ben5049/GbE-TSN-Switch/Documentation/Images/RGMII MAC-PHY.png

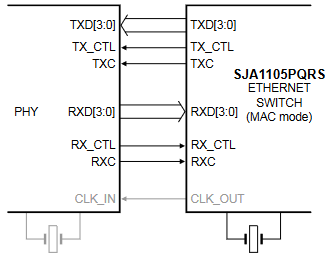
Documentation/Images/RGMII MAC-PHY.png
