ben5049/GbE-TSN-Switch/PCBs/component_library/switch_models/PCM12SMTR.stp

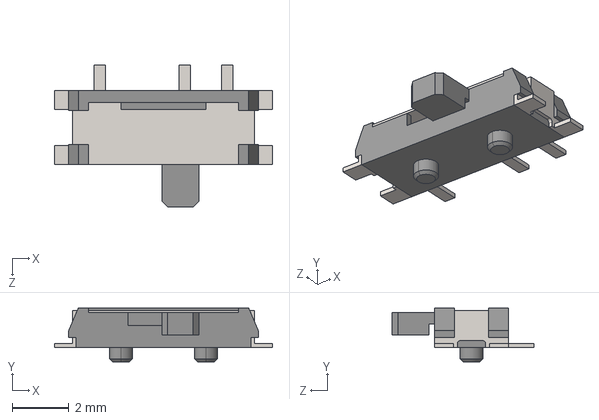
[picture p2: CAD file, 2024-04-11]
PCBs/component_library/switch_models/PCM12SMTR.stp
7.70 x 1.90 x 5.00 mm
