ben5049/GbE-TSN-Switch/PCBs/component_library/switch_models/STM32H573IIK3Q.step

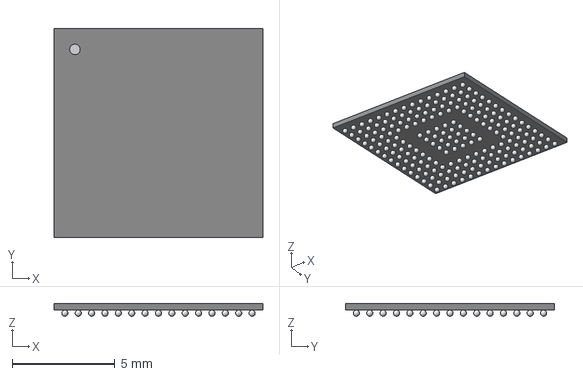
[picture p3: CAD file, 2024-04-11]
PCBs/component_library/switch_models/STM32H573IIK3Q.step
10.2 x 10.2 x 0.612 mm
