ben5049/GbE-TSN-Switch/PCBs/component_library/switch_models/FTSH-107-01-L-DV-K.stp

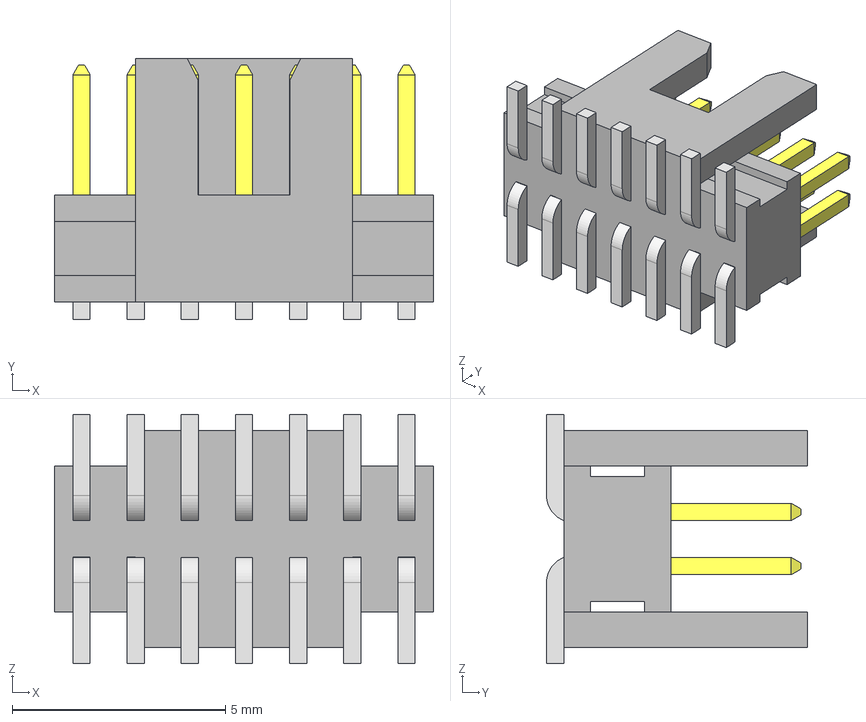
[picture p4: CAD file, 2024-04-11]
PCBs/component_library/switch_models/FTSH-107-01-L-DV-K.stp
8.89 x 6.12 x 5.84 mm
FTSH-107-01-L-DV-K_pins2
FTSH-107-01-L-DV-K_pins1
FTSH-107-01-L-DV-K_body
