ben5049/GbE-TSN-Switch/PCBs/component_library/switch_models/TPD4S012DRYR.stp

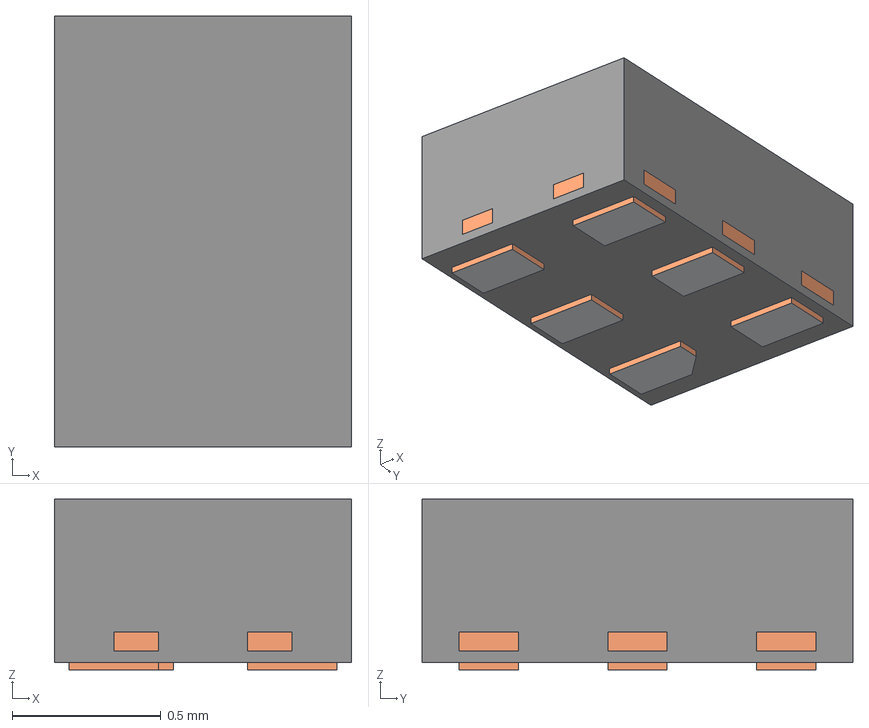
[picture p5: CAD file, 2024-04-11]
PCBs/component_library/switch_models/TPD4S012DRYR.stp
1.00 x 1.45 x 0.575 mm
BODY-SON
FRAME-DRY0006A
PIN1-ID
