ben5049/GbE-TSN-Switch/PCBs/component_library/switch_models/SRF7035A-301Y.stp

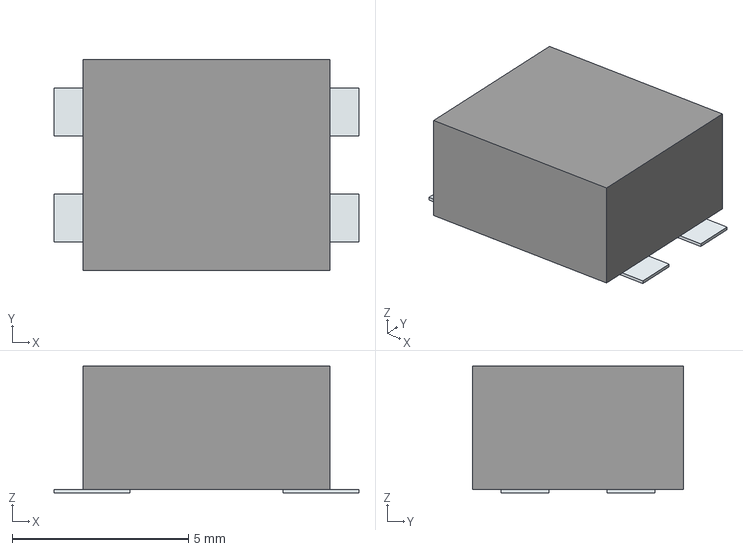
[picture p6: CAD file, 2024-04-09]
PCBs/component_library/switch_models/SRF7035A-301Y.stp
8.66 x 6.00 x 3.60 mm
Pins
