ben5049/GbE-TSN-Switch/PCBs/component_library/switch_models/SRF4532-110Y.stp

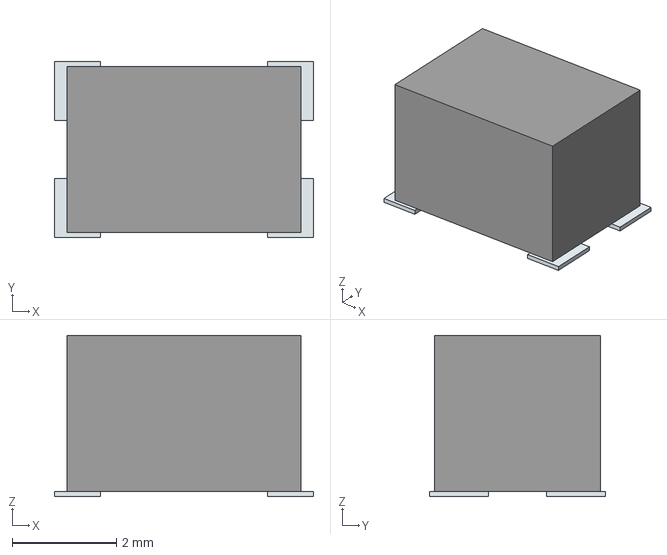
[picture p7: CAD file, 2024-04-09]
PCBs/component_library/switch_models/SRF4532-110Y.stp
4.98 x 3.38 x 3.10 mm
Pins
