ben5049/GbE-TSN-Switch/PCBs/component_library/switch_models/ESD8708MUTAG.stp

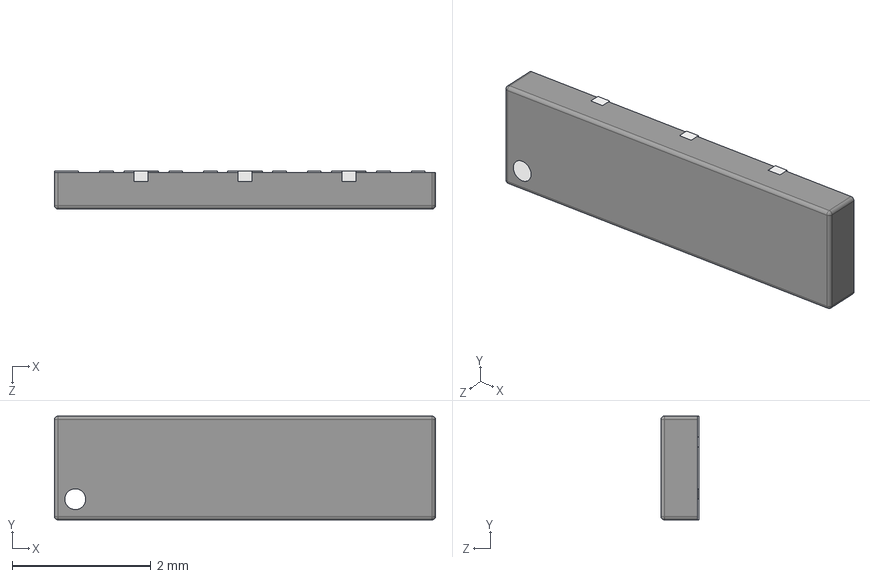
[picture p8: CAD file, 2024-04-07]
PCBs/component_library/switch_models/ESD8708MUTAG.stp
5.50 x 1.50 x 0.55 mm
