ben5049/GbE-TSN-Switch/PCBs/component_library/switch_models/PESD2CANFD24V-TR.stp

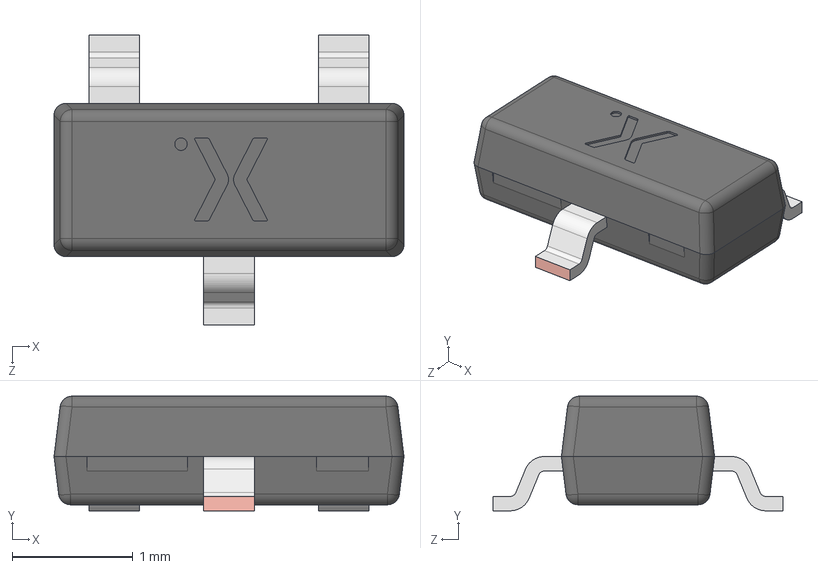
[picture p9: CAD file, 2024-04-06]
PCBs/component_library/switch_models/PESD2CANFD24V-TR.stp
2.90 x 0.95 x 2.40 mm
SOT23 lower body
SOT23 Lead x 3
SOT23 Upper body
