ben5049/GbE-TSN-Switch/PCBs/component_library/switch_models/Diodes_Incorporated_-_DMTH6016LPSQ-13.step

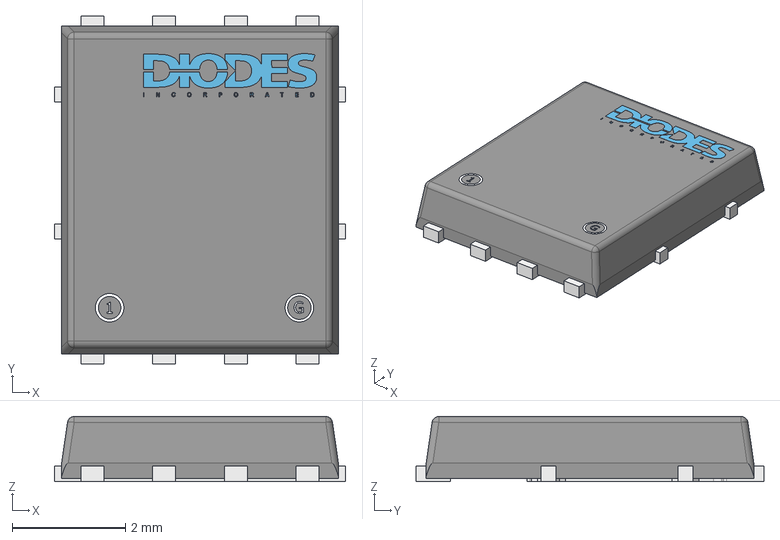
[picture p10: CAD file, 2024-04-05]
PCBs/component_library/switch_models/Diodes_Incorporated_-_DMTH6016LPSQ-13.step
5.15 x 6.15 x 1.15 mm
