ben5049/GbE-TSN-Switch/PCBs/component_library/switch_models/TS20-42-25-WT-160-SMT-TR-MSL.stp

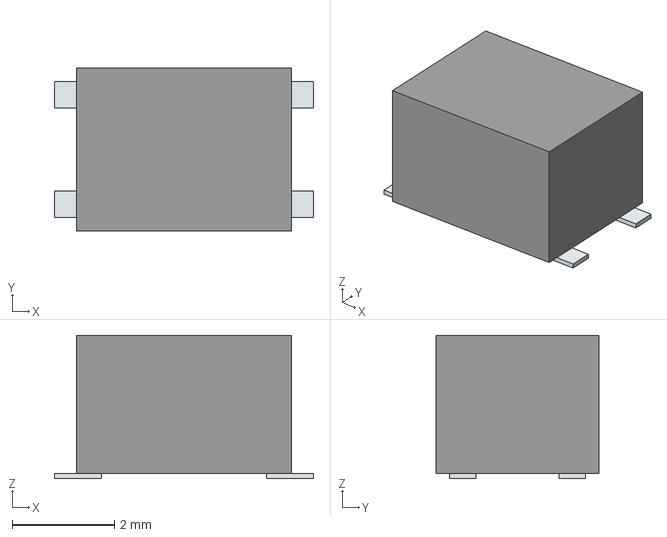
[picture p11: CAD file, 2024-04-05]
PCBs/component_library/switch_models/TS20-42-25-WT-160-SMT-TR-MSL.stp
5.07 x 3.20 x 2.80 mm
Pins
