ben5049/GbE-TSN-Switch/PCBs/component_library/switch_models/PJ-002AH.stp

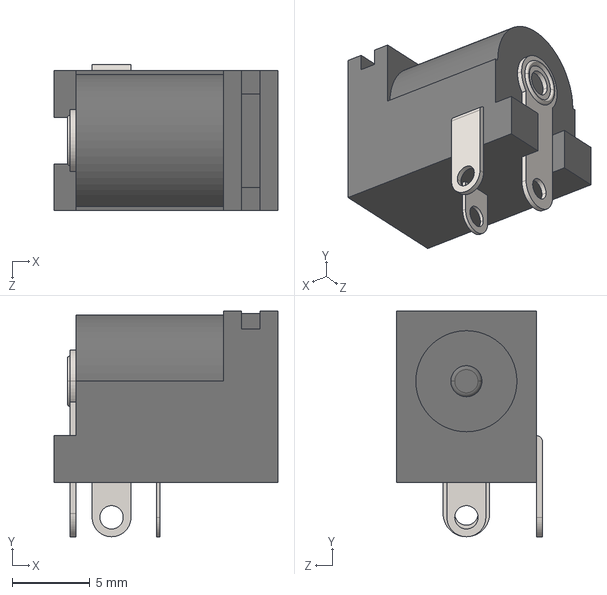
[picture p12: CAD file, 2024-04-05]
PCBs/component_library/switch_models/PJ-002AH.stp
14.4 x 14.5 x 9.40 mm
