ben5049/GbE-TSN-Switch/PCBs/component_library/switch_models/MPQ5850GJ-AEC1-Z.stp

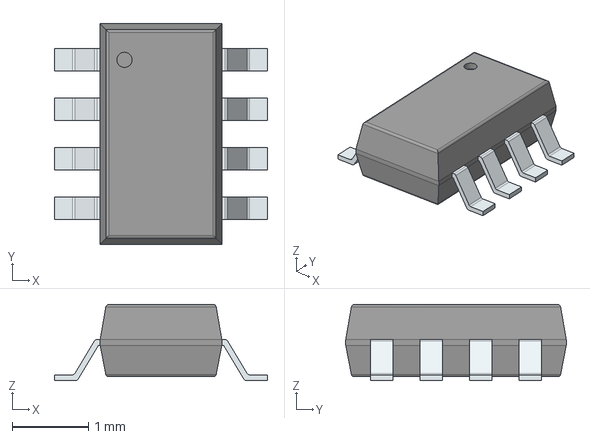
[picture p13: CAD file, 2024-04-05]
PCBs/component_library/switch_models/MPQ5850GJ-AEC1-Z.stp
2.80 x 2.90 x 1.00 mm
PinsArrayLR
