ben5049/GbE-TSN-Switch/PCBs/component_library/switch_models/LT8692s.step

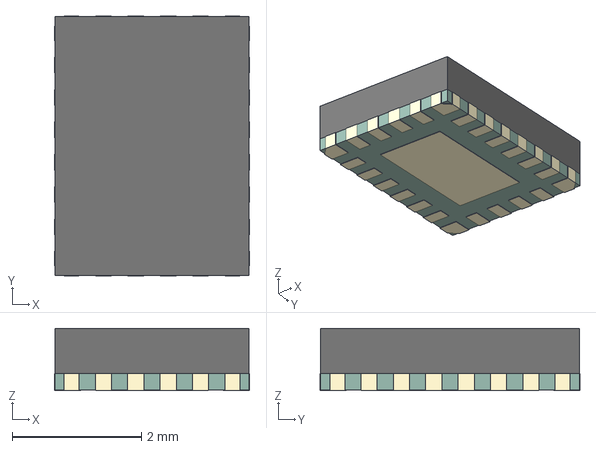
[picture p14: CAD file, 2024-04-05]
PCBs/component_library/switch_models/LT8692s.step
3.02 x 4.02 x 0.96 mm
