ben5049/GbE-TSN-Switch/PCBs/component_library/switch_models/AXGD10402KR.stp

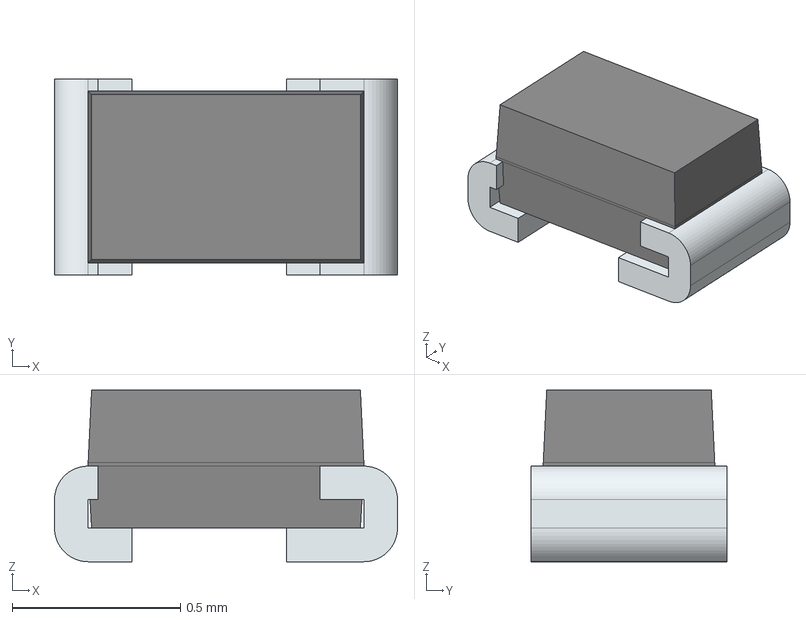
[picture p15: CAD file, 2024-04-05]
PCBs/component_library/switch_models/AXGD10402KR.stp
1.02 x 0.584 x 0.51 mm
FilletPin1
FilletPin2
