ben5049/GbE-TSN-Switch/PCBs/component_library/switch_models/TVS2701DRBR.stp

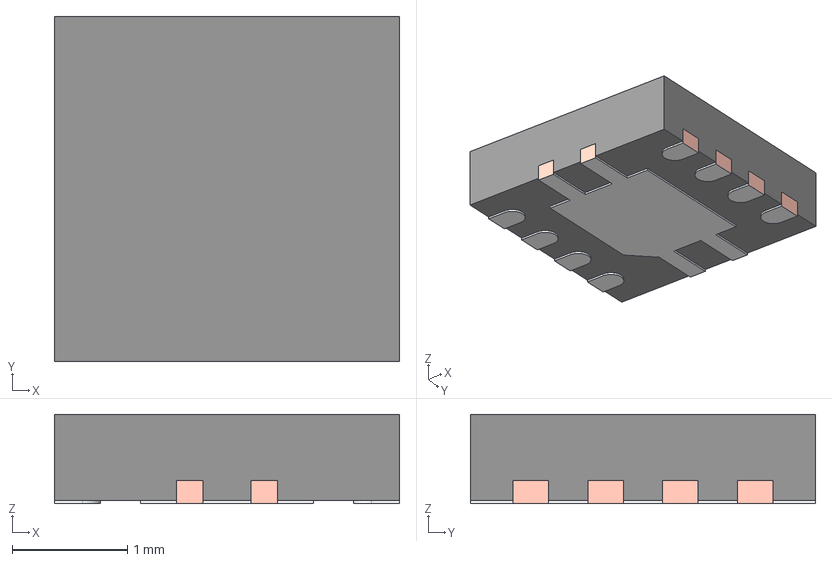
[picture p17: CAD file, 2024-04-05]
PCBs/component_library/switch_models/TVS2701DRBR.stp
3.00 x 3.00 x 0.775 mm
BODY-SON
FRAME-DRB0008A
