ben5049/GbE-TSN-Switch/PCBs/component_library/switch_models/TMJG46945AENL_Web.STEP

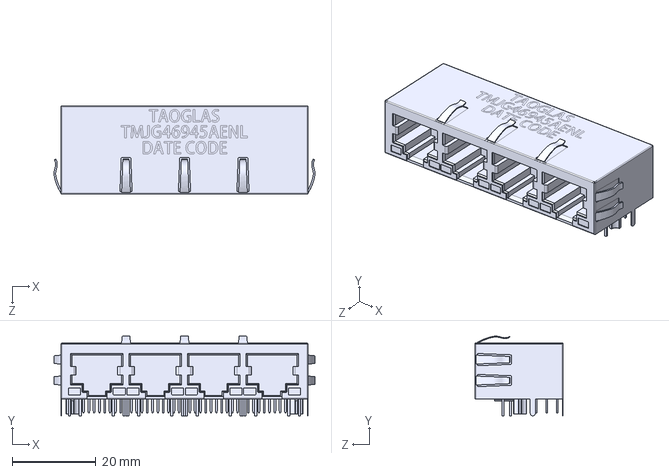
[picture p18: CAD file, 2024-04-05]
PCBs/component_library/switch_models/TMJG46945AENL_Web.STEP
62.4 x 19.0 x 21.1 mm
