ben5049/GbE-TSN-Switch/PCBs/component_library/switch_models/TJA1055T_3_2Z.stp

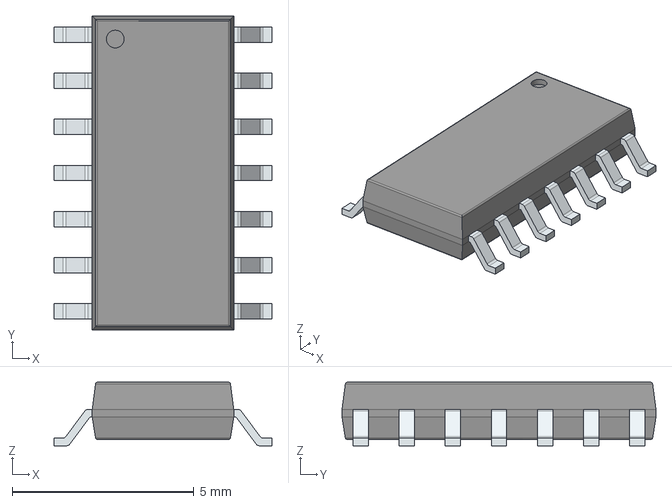
[picture p19: CAD file, 2024-04-05]
PCBs/component_library/switch_models/TJA1055T_3_2Z.stp
6.00 x 8.65 x 1.75 mm
PinsArrayLR
