ben5049/GbE-TSN-Switch/(list of files, cad)

Other CAD files:
PCBs/component_library/switch_models/76825-0004.stp
PCBs/component_library/switch_models/DP83867CSRGZR.stp
PCBs/component_library/switch_models/LMR34206SC5QRNXRQ1.step
PCBs/component_library/switch_models/M24256X-FCU6T_VF.stp
PCBs/component_library/switch_models/STM32H573IIK3Q.stp
PCBs/component_library/switch_models/TPS16416DRCR.stp
