ben5049/GbE-TSN-Switch/PCBs/switch_main_v1/switch_main_v1.kicad_pcb

## KiCad design PCBs/switch_main_v1/switch_main_v1.kicad_pcb (2024-04-11)

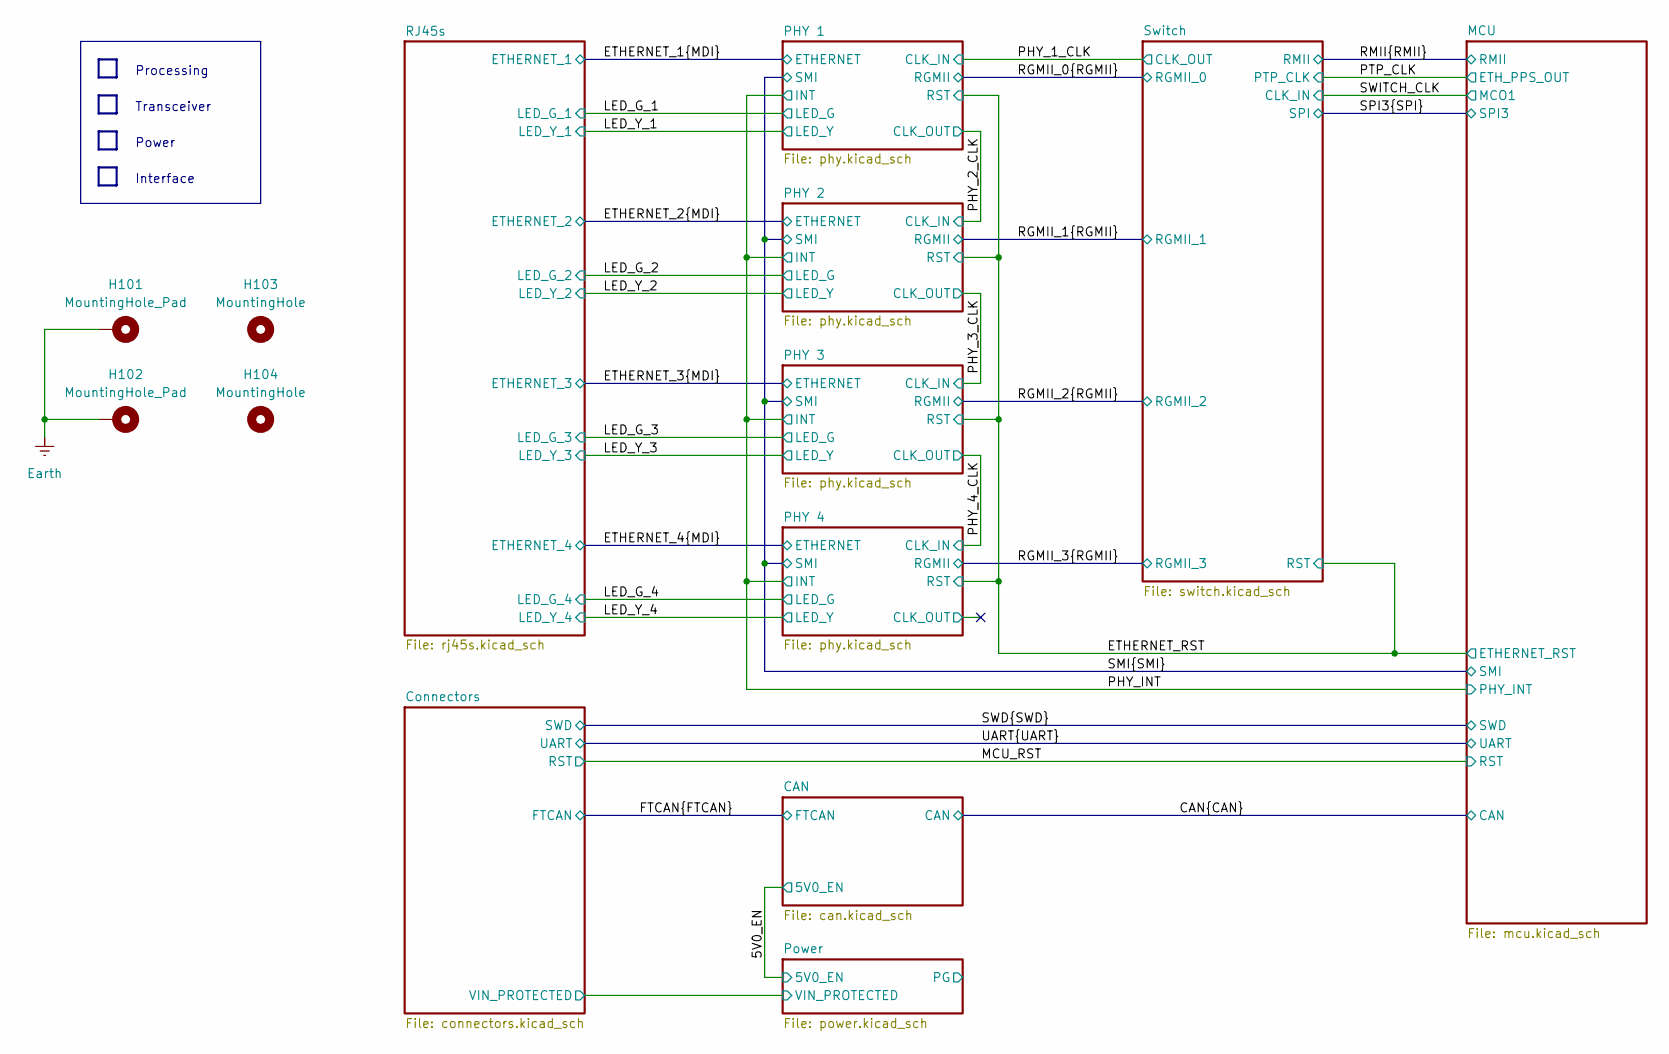
[picture p20: schematic switch_main_v1.kicad_sch, GbE TSN Switch Block Diagram]

Parts:
H101, H102: MountingHole_Pad; MountingHole_3.2mm_M3_DIN965_Pad_TopBottom
H103, H104: MountingHole; MountingHole_3.2mm_M3_DIN965

Connections:
Earth: H101.1, H102.1; also elsewhere on the board

Notes on the sheet:
Processing
Power
Interface
Transceiver

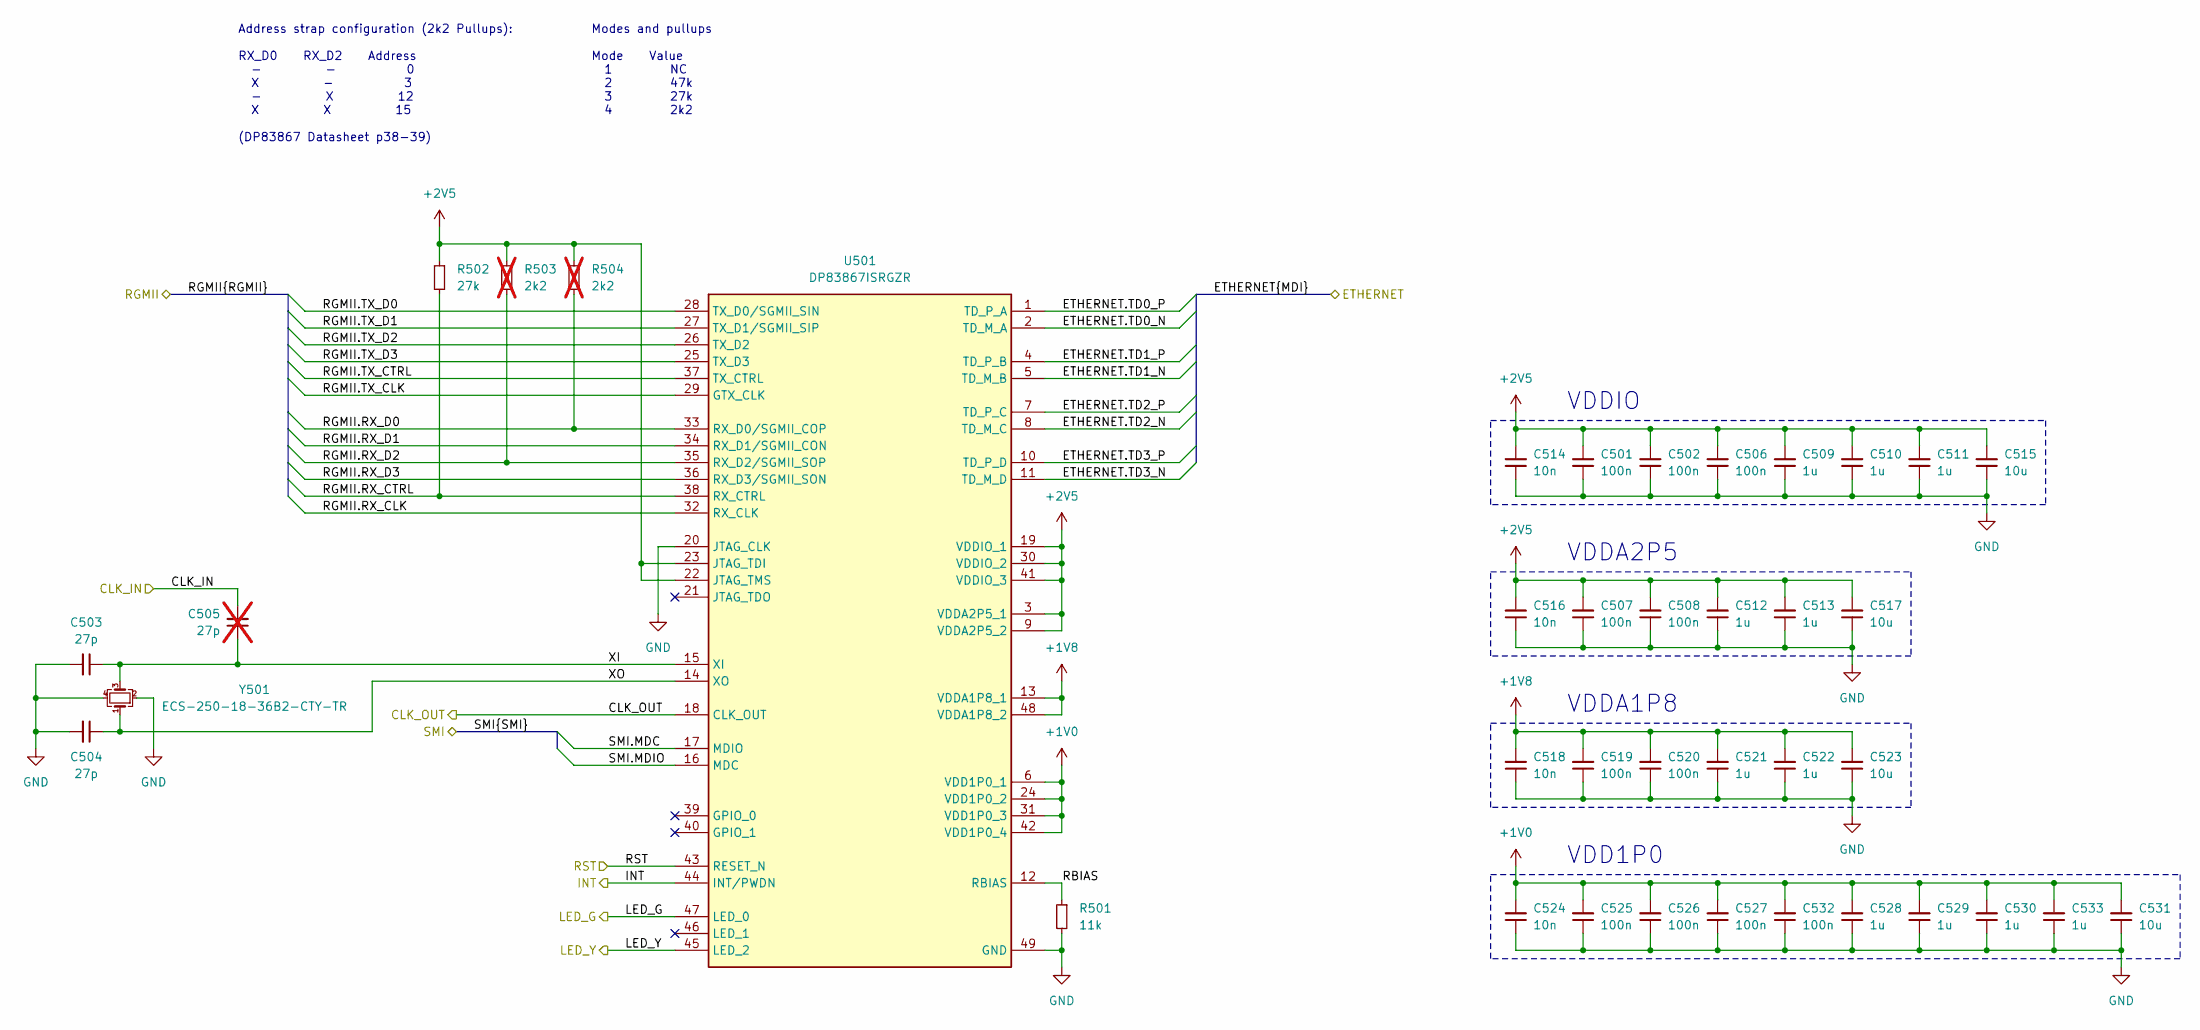
[picture p21: schematic phy.kicad_sch]

Parts:
C501, C502, C506, C507, C508, C519, C520, C525, C526, C527, C532: 100n; C_0402_1005Metric
C503, C504: 27p; C_0402_1005Metric
C505: 27p; C_0402_1005Metric; not fitted
C509, C510, C511, C512, C513, C521, C522, C528, C529, C530, C533: 1u; C_0402_1005Metric
C514, C516, C518, C524: 10n; C_0402_1005Metric
C515, C517, C523, C531: 10u; C_0402_1005Metric
R501: 11k; R_0402_1005Metric
R502: 27k; R_0402_1005Metric
R503, R504: 2k2; R_0402_1005Metric; not fitted
U501: DP83867ISRGZR; QFN50P700X700X100-49N-D; Mouser Part Number 595-DP83867CSRGZR
Y501: ECS-250-18-36B2-CTY-TR; Crystal_SMD_2520-4Pin_2.5x2.0mm

Connections:
+1V0: C524.2, C525.2, C526.2, C527.2, C528.2, C529.2, C530.2, C531.2, C532.2, C533.2, U501.6 (VDD1P0_1), U501.24 (VDD1P0_2), U501.31 (VDD1P0_3), U501.42 (VDD1P0_4); also elsewhere on the board
+1V8: C518.2, C519.2, C520.2, C521.2, C522.2, C523.2, U501.13 (VDDA1P8_1), U501.48 (VDDA1P8_2); also elsewhere on the board
+2V5: C501.2, C502.2, C506.2, C507.2, C508.2, C509.2, C510.2, C511.2, C512.2, C513.2, C514.2, C515.2, C516.2, C517.2, R502.1, R503.1, R504.1, U501.3 (VDDA2P5_1), U501.9 (VDDA2P5_2), U501.19 (VDDIO_1), U501.22 (JTAG_TMS), U501.23 (JTAG_TDI), U501.30 (VDDIO_2), U501.41 (VDDIO_3); also elsewhere on the board
/ETHERNET_1.TD0_N: U501.2 (TD_M_A); also elsewhere on the board
/ETHERNET_1.TD0_P: U501.1 (TD_P_A); also elsewhere on the board
/ETHERNET_1.TD1_N: U501.5 (TD_M_B); also elsewhere on the board
/ETHERNET_1.TD1_P: U501.4 (TD_P_B); also elsewhere on the board
/ETHERNET_1.TD2_N: U501.8 (TD_M_C); also elsewhere on the board
/ETHERNET_1.TD2_P: U501.7 (TD_P_C); also elsewhere on the board
/ETHERNET_1.TD3_N: U501.11 (TD_M_D); also elsewhere on the board
/ETHERNET_1.TD3_P: U501.10 (TD_P_D); also elsewhere on the board
/ETHERNET_RST: U501.43 (RESET_N); also elsewhere on the board
/LED_G_1: U501.47 (LED_0); also elsewhere on the board
/LED_Y_1: U501.45 (LED_2); also elsewhere on the board
/PHY 1/RBIAS: R501.1, U501.12 (RBIAS)
/PHY 1/XI: C503.1, C505.1, U501.15 (XI), Y501.3
/PHY 1/XO: C504.1, U501.14 (XO), Y501.1
/PHY_1_CLK: C505.2; also elsewhere on the board
/PHY_2_CLK: U501.18 (CLK_OUT); also elsewhere on the board
/PHY_INT: U501.44 (INT/PWDN); also elsewhere on the board
/RGMII_0.RX_CLK: U501.32 (RX_CLK); also elsewhere on the board
/RGMII_0.RX_CTRL: R502.2, U501.38 (RX_CTRL); also elsewhere on the board
/RGMII_0.RX_D0: R504.2, U501.33 (RX_D0/SGMII_COP); also elsewhere on the board
/RGMII_0.RX_D1: U501.34 (RX_D1/SGMII_CON); also elsewhere on the board
/RGMII_0.RX_D2: R503.2, U501.35 (RX_D2/SGMII_SOP); also elsewhere on the board
/RGMII_0.RX_D3: U501.36 (RX_D3/SGMII_SON); also elsewhere on the board
/RGMII_0.TX_CLK: U501.29 (GTX_CLK); also elsewhere on the board
/RGMII_0.TX_CTRL: U501.37 (TX_CTRL); also elsewhere on the board
/RGMII_0.TX_D0: U501.28 (TX_D0/SGMII_SIN); also elsewhere on the board
/RGMII_0.TX_D1: U501.27 (TX_D1/SGMII_SIP); also elsewhere on the board
/RGMII_0.TX_D2: U501.26 (TX_D2); also elsewhere on the board
/RGMII_0.TX_D3: U501.25 (TX_D3); also elsewhere on the board
/SMI.MDC: U501.17 (MDIO); also elsewhere on the board
/SMI.MDIO: U501.16 (MDC); also elsewhere on the board
GND: C501.1, C502.1, C503.2, C504.2, C506.1, C507.1, C508.1, C509.1, C510.1, C511.1, C512.1, C513.1, C514.1, C515.1, C516.1, C517.1, C518.1, C519.1, C520.1, C521.1, C522.1, C523.1, C524.1, C525.1, C526.1, C527.1, C528.1, C529.1, C530.1, C531.1, C532.1, C533.1, R501.2, U501.20 (JTAG_CLK), U501.49 (GND), Y501.2, Y501.4; also elsewhere on the board

Parts of its further copies:
C601, C602, C606, C607, C608, C619, C620, C625, C626, C627, C632, C701, C702, C706, C707, C708, C719, C720, C725, C726, C727, C732, C801, C802, C806, C807, C808, C819, C820, C825, C826, C827, C832: 100n; C_0402_1005Metric
C603, C604, C703, C704, C803, C804: 27p; C_0402_1005Metric
C605, C705, C805: 27p; C_0402_1005Metric; not fitted
C609, C610, C611, C612, C613, C621, C622, C628, C629, C630, C633, C709, C710, C711, C712, C713, C721, C722, C728, C729, C730, C733, C809, C810, C811, C812, C813, C821, C822, C828, C829, C830, C833: 1u; C_0402_1005Metric
C614, C616, C618, C624, C714, C716, C718, C724, C814, C816, C818, C824: 10n; C_0402_1005Metric
C615, C617, C623, C631, C715, C717, C723, C731, C815, C817, C823, C831: 10u; C_0402_1005Metric
R601, R701, R801: 11k; R_0402_1005Metric
R602, R702, R802: 27k; R_0402_1005Metric
R603, R604, R703, R704, R803, R804: 2k2; R_0402_1005Metric; not fitted
U601, U701, U801: DP83867ISRGZR; QFN50P700X700X100-49N-D; Mouser Part Number 595-DP83867CSRGZR
Y601, Y701, Y801: ECS-250-18-36B2-CTY-TR; Crystal_SMD_2520-4Pin_2.5x2.0mm

Connections of its further copies:
+1V0: C624.2, C625.2, C626.2, C627.2, C628.2, C629.2, C630.2, C631.2, C632.2, C633.2, C724.2, C725.2, C726.2, C727.2, C728.2, C729.2, C730.2, C731.2, C732.2, C733.2, C824.2, C825.2, C826.2, C827.2, C828.2, C829.2, C830.2, C831.2, C832.2, C833.2, U601.6 (VDD1P0_1), U601.24 (VDD1P0_2), U601.31 (VDD1P0_3), U601.42 (VDD1P0_4), U701.6 (VDD1P0_1), U701.24 (VDD1P0_2), U701.31 (VDD1P0_3), U701.42 (VDD1P0_4), U801.6 (VDD1P0_1), U801.24 (VDD1P0_2), U801.31 (VDD1P0_3), U801.42 (VDD1P0_4); also elsewhere on the board
+1V8: C618.2, C619.2, C620.2, C621.2, C622.2, C623.2, C718.2, C719.2, C720.2, C721.2, C722.2, C723.2, C818.2, C819.2, C820.2, C821.2, C822.2, C823.2, U601.13 (VDDA1P8_1), U601.48 (VDDA1P8_2), U701.13 (VDDA1P8_1), U701.48 (VDDA1P8_2), U801.13 (VDDA1P8_1), U801.48 (VDDA1P8_2); also elsewhere on the board
+2V5: C601.2, C602.2, C606.2, C607.2, C608.2, C609.2, C610.2, C611.2, C612.2, C613.2, C614.2, C615.2, C616.2, C617.2, C701.2, C702.2, C706.2, C707.2, C708.2, C709.2, C710.2, C711.2, C712.2, C713.2, C714.2, C715.2, C716.2, C717.2, C801.2, C802.2, C806.2, C807.2, C808.2, C809.2, C810.2, C811.2, C812.2, C813.2, C814.2, C815.2, C816.2, C817.2, R602.1, R603.1, R604.1, R702.1, R703.1, R704.1, R802.1, R803.1, R804.1, U601.3 (VDDA2P5_1), U601.9 (VDDA2P5_2), U601.19 (VDDIO_1), U601.22 (JTAG_TMS), U601.23 (JTAG_TDI), U601.30 (VDDIO_2), U601.41 (VDDIO_3), U701.3 (VDDA2P5_1), U701.9 (VDDA2P5_2), U701.19 (VDDIO_1), U701.22 (JTAG_TMS), U701.23 (JTAG_TDI), U701.30 (VDDIO_2), U701.41 (VDDIO_3), U801.3 (VDDA2P5_1), U801.9 (VDDA2P5_2), U801.19 (VDDIO_1), U801.22 (JTAG_TMS), U801.23 (JTAG_TDI), U801.30 (VDDIO_2), U801.41 (VDDIO_3); also elsewhere on the board
/ETHERNET_2.TD0_N: U601.2 (TD_M_A); also elsewhere on the board
/ETHERNET_2.TD0_P: U601.1 (TD_P_A); also elsewhere on the board
/ETHERNET_2.TD1_N: U601.5 (TD_M_B); also elsewhere on the board
/ETHERNET_2.TD1_P: U601.4 (TD_P_B); also elsewhere on the board
/ETHERNET_2.TD2_N: U601.8 (TD_M_C); also elsewhere on the board
/ETHERNET_2.TD2_P: U601.7 (TD_P_C); also elsewhere on the board
/ETHERNET_2.TD3_N: U601.11 (TD_M_D); also elsewhere on the board
/ETHERNET_2.TD3_P: U601.10 (TD_P_D); also elsewhere on the board
/ETHERNET_3.TD0_N: U701.2 (TD_M_A); also elsewhere on the board
/ETHERNET_3.TD0_P: U701.1 (TD_P_A); also elsewhere on the board
/ETHERNET_3.TD1_N: U701.5 (TD_M_B); also elsewhere on the board
/ETHERNET_3.TD1_P: U701.4 (TD_P_B); also elsewhere on the board
/ETHERNET_3.TD2_N: U701.8 (TD_M_C); also elsewhere on the board
/ETHERNET_3.TD2_P: U701.7 (TD_P_C); also elsewhere on the board
/ETHERNET_3.TD3_N: U701.11 (TD_M_D); also elsewhere on the board
/ETHERNET_3.TD3_P: U701.10 (TD_P_D); also elsewhere on the board
/ETHERNET_4.TD0_N: U801.2 (TD_M_A); also elsewhere on the board
/ETHERNET_4.TD0_P: U801.1 (TD_P_A); also elsewhere on the board
/ETHERNET_4.TD1_N: U801.5 (TD_M_B); also elsewhere on the board
/ETHERNET_4.TD1_P: U801.4 (TD_P_B); also elsewhere on the board
/ETHERNET_4.TD2_N: U801.8 (TD_M_C); also elsewhere on the board
/ETHERNET_4.TD2_P: U801.7 (TD_P_C); also elsewhere on the board
/ETHERNET_4.TD3_N: U801.11 (TD_M_D); also elsewhere on the board
/ETHERNET_4.TD3_P: U801.10 (TD_P_D); also elsewhere on the board
/ETHERNET_RST: U601.43 (RESET_N), U701.43 (RESET_N), U801.43 (RESET_N); also elsewhere on the board
/LED_G_2: U601.47 (LED_0); also elsewhere on the board
/LED_G_3: U701.47 (LED_0); also elsewhere on the board
/LED_G_4: U801.47 (LED_0); also elsewhere on the board
/LED_Y_2: U601.45 (LED_2); also elsewhere on the board
/LED_Y_3: U701.45 (LED_2); also elsewhere on the board
/LED_Y_4: U801.45 (LED_2); also elsewhere on the board
/PHY 2/RBIAS: R601.1, U601.12 (RBIAS)
/PHY 2/XI: C603.1, C605.1, U601.15 (XI), Y601.3
/PHY 2/XO: C604.1, U601.14 (XO), Y601.1
/PHY 3/RBIAS: R701.1, U701.12 (RBIAS)
/PHY 3/XI: C703.1, C705.1, U701.15 (XI), Y701.3
/PHY 3/XO: C704.1, U701.14 (XO), Y701.1
/PHY 4/CLK_OUT: U801.18 (CLK_OUT)
/PHY 4/RBIAS: R801.1, U801.12 (RBIAS)
/PHY 4/XI: C803.1, C805.1, U801.15 (XI), Y801.3
/PHY 4/XO: C804.1, U801.14 (XO), Y801.1
/PHY_2_CLK: C605.2; also elsewhere on the board
/PHY_3_CLK: C705.2, U601.18 (CLK_OUT)
/PHY_4_CLK: C805.2, U701.18 (CLK_OUT)
/PHY_INT: U601.44 (INT/PWDN), U701.44 (INT/PWDN), U801.44 (INT/PWDN); also elsewhere on the board
/RGMII_1.RX_CLK: U601.32 (RX_CLK); also elsewhere on the board
/RGMII_1.RX_CTRL: R602.2, U601.38 (RX_CTRL); also elsewhere on the board
/RGMII_1.RX_D0: R604.2, U601.33 (RX_D0/SGMII_COP); also elsewhere on the board
/RGMII_1.RX_D1: U601.34 (RX_D1/SGMII_CON); also elsewhere on the board
/RGMII_1.RX_D2: R603.2, U601.35 (RX_D2/SGMII_SOP); also elsewhere on the board
/RGMII_1.RX_D3: U601.36 (RX_D3/SGMII_SON); also elsewhere on the board
/RGMII_1.TX_CLK: U601.29 (GTX_CLK); also elsewhere on the board
/RGMII_1.TX_CTRL: U601.37 (TX_CTRL); also elsewhere on the board
/RGMII_1.TX_D0: U601.28 (TX_D0/SGMII_SIN); also elsewhere on the board
/RGMII_1.TX_D1: U601.27 (TX_D1/SGMII_SIP); also elsewhere on the board
/RGMII_1.TX_D2: U601.26 (TX_D2); also elsewhere on the board
/RGMII_1.TX_D3: U601.25 (TX_D3); also elsewhere on the board
/RGMII_2.RX_CLK: U701.32 (RX_CLK); also elsewhere on the board
/RGMII_2.RX_CTRL: R702.2, U701.38 (RX_CTRL); also elsewhere on the board
/RGMII_2.RX_D0: R704.2, U701.33 (RX_D0/SGMII_COP); also elsewhere on the board
/RGMII_2.RX_D1: U701.34 (RX_D1/SGMII_CON); also elsewhere on the board
/RGMII_2.RX_D2: R703.2, U701.35 (RX_D2/SGMII_SOP); also elsewhere on the board
/RGMII_2.RX_D3: U701.36 (RX_D3/SGMII_SON); also elsewhere on the board
/RGMII_2.TX_CLK: U701.29 (GTX_CLK); also elsewhere on the board
/RGMII_2.TX_CTRL: U701.37 (TX_CTRL); also elsewhere on the board
/RGMII_2.TX_D0: U701.28 (TX_D0/SGMII_SIN); also elsewhere on the board
/RGMII_2.TX_D1: U701.27 (TX_D1/SGMII_SIP); also elsewhere on the board
/RGMII_2.TX_D2: U701.26 (TX_D2); also elsewhere on the board
/RGMII_2.TX_D3: U701.25 (TX_D3); also elsewhere on the board
/RGMII_3.RX_CLK: U801.32 (RX_CLK); also elsewhere on the board
/RGMII_3.RX_CTRL: R802.2, U801.38 (RX_CTRL); also elsewhere on the board
/RGMII_3.RX_D0: R804.2, U801.33 (RX_D0/SGMII_COP); also elsewhere on the board
/RGMII_3.RX_D1: U801.34 (RX_D1/SGMII_CON); also elsewhere on the board
/RGMII_3.RX_D2: R803.2, U801.35 (RX_D2/SGMII_SOP); also elsewhere on the board
/RGMII_3.RX_D3: U801.36 (RX_D3/SGMII_SON); also elsewhere on the board
/RGMII_3.TX_CLK: U801.29 (GTX_CLK); also elsewhere on the board
/RGMII_3.TX_CTRL: U801.37 (TX_CTRL); also elsewhere on the board
/RGMII_3.TX_D0: U801.28 (TX_D0/SGMII_SIN); also elsewhere on the board
/RGMII_3.TX_D1: U801.27 (TX_D1/SGMII_SIP); also elsewhere on the board
/RGMII_3.TX_D2: U801.26 (TX_D2); also elsewhere on the board
/RGMII_3.TX_D3: U801.25 (TX_D3); also elsewhere on the board
/SMI.MDC: U601.17 (MDIO), U701.17 (MDIO), U801.17 (MDIO); also elsewhere on the board
/SMI.MDIO: U601.16 (MDC), U701.16 (MDC), U801.16 (MDC); also elsewhere on the board
GND: C601.1, C602.1, C603.2, C604.2, C606.1, C607.1, C608.1, C609.1, C610.1, C611.1, C612.1, C613.1, C614.1, C615.1, C616.1, C617.1, C618.1, C619.1, C620.1, C621.1, C622.1, C623.1, C624.1, C625.1, C626.1, C627.1, C628.1, C629.1, C630.1, C631.1, C632.1, C633.1, C701.1, C702.1, C703.2, C704.2, C706.1, C707.1, C708.1, C709.1, C710.1, C711.1, C712.1, C713.1, C714.1, C715.1, C716.1, C717.1, C718.1, C719.1, C720.1, C721.1, C722.1, C723.1, C724.1, C725.1, C726.1, C727.1, C728.1, C729.1, C730.1, C731.1, C732.1, C733.1, C801.1, C802.1, C803.2, C804.2, C806.1, C807.1, C808.1, C809.1, C810.1, C811.1, C812.1, C813.1, C814.1, C815.1, C816.1, C817.1, C818.1, C819.1, C820.1, C821.1, C822.1, C823.1, C824.1, C825.1, C826.1, C827.1, C828.1, C829.1, C830.1, C831.1, C832.1, C833.1, R601.2, R701.2, R801.2, U601.20 (JTAG_CLK), U601.49 (GND), U701.20 (JTAG_CLK), U701.49 (GND), U801.20 (JTAG_CLK), U801.49 (GND), Y601.2, Y601.4, Y701.2, Y701.4, Y801.2, Y801.4; also elsewhere on the board

Notes on the sheet:
VDDIO
VDD1P0
Address strap configuration (2k2 Pullups): RX_D0 RX_D2 Address - - 0 X - 3 - X 12 X X 15 (DP83867 Datasheet p38-39)
VDDA1P8
VDDA2P5
Modes and pullups Mode Value 1 NC 2 47k 3 27k 4 2k2

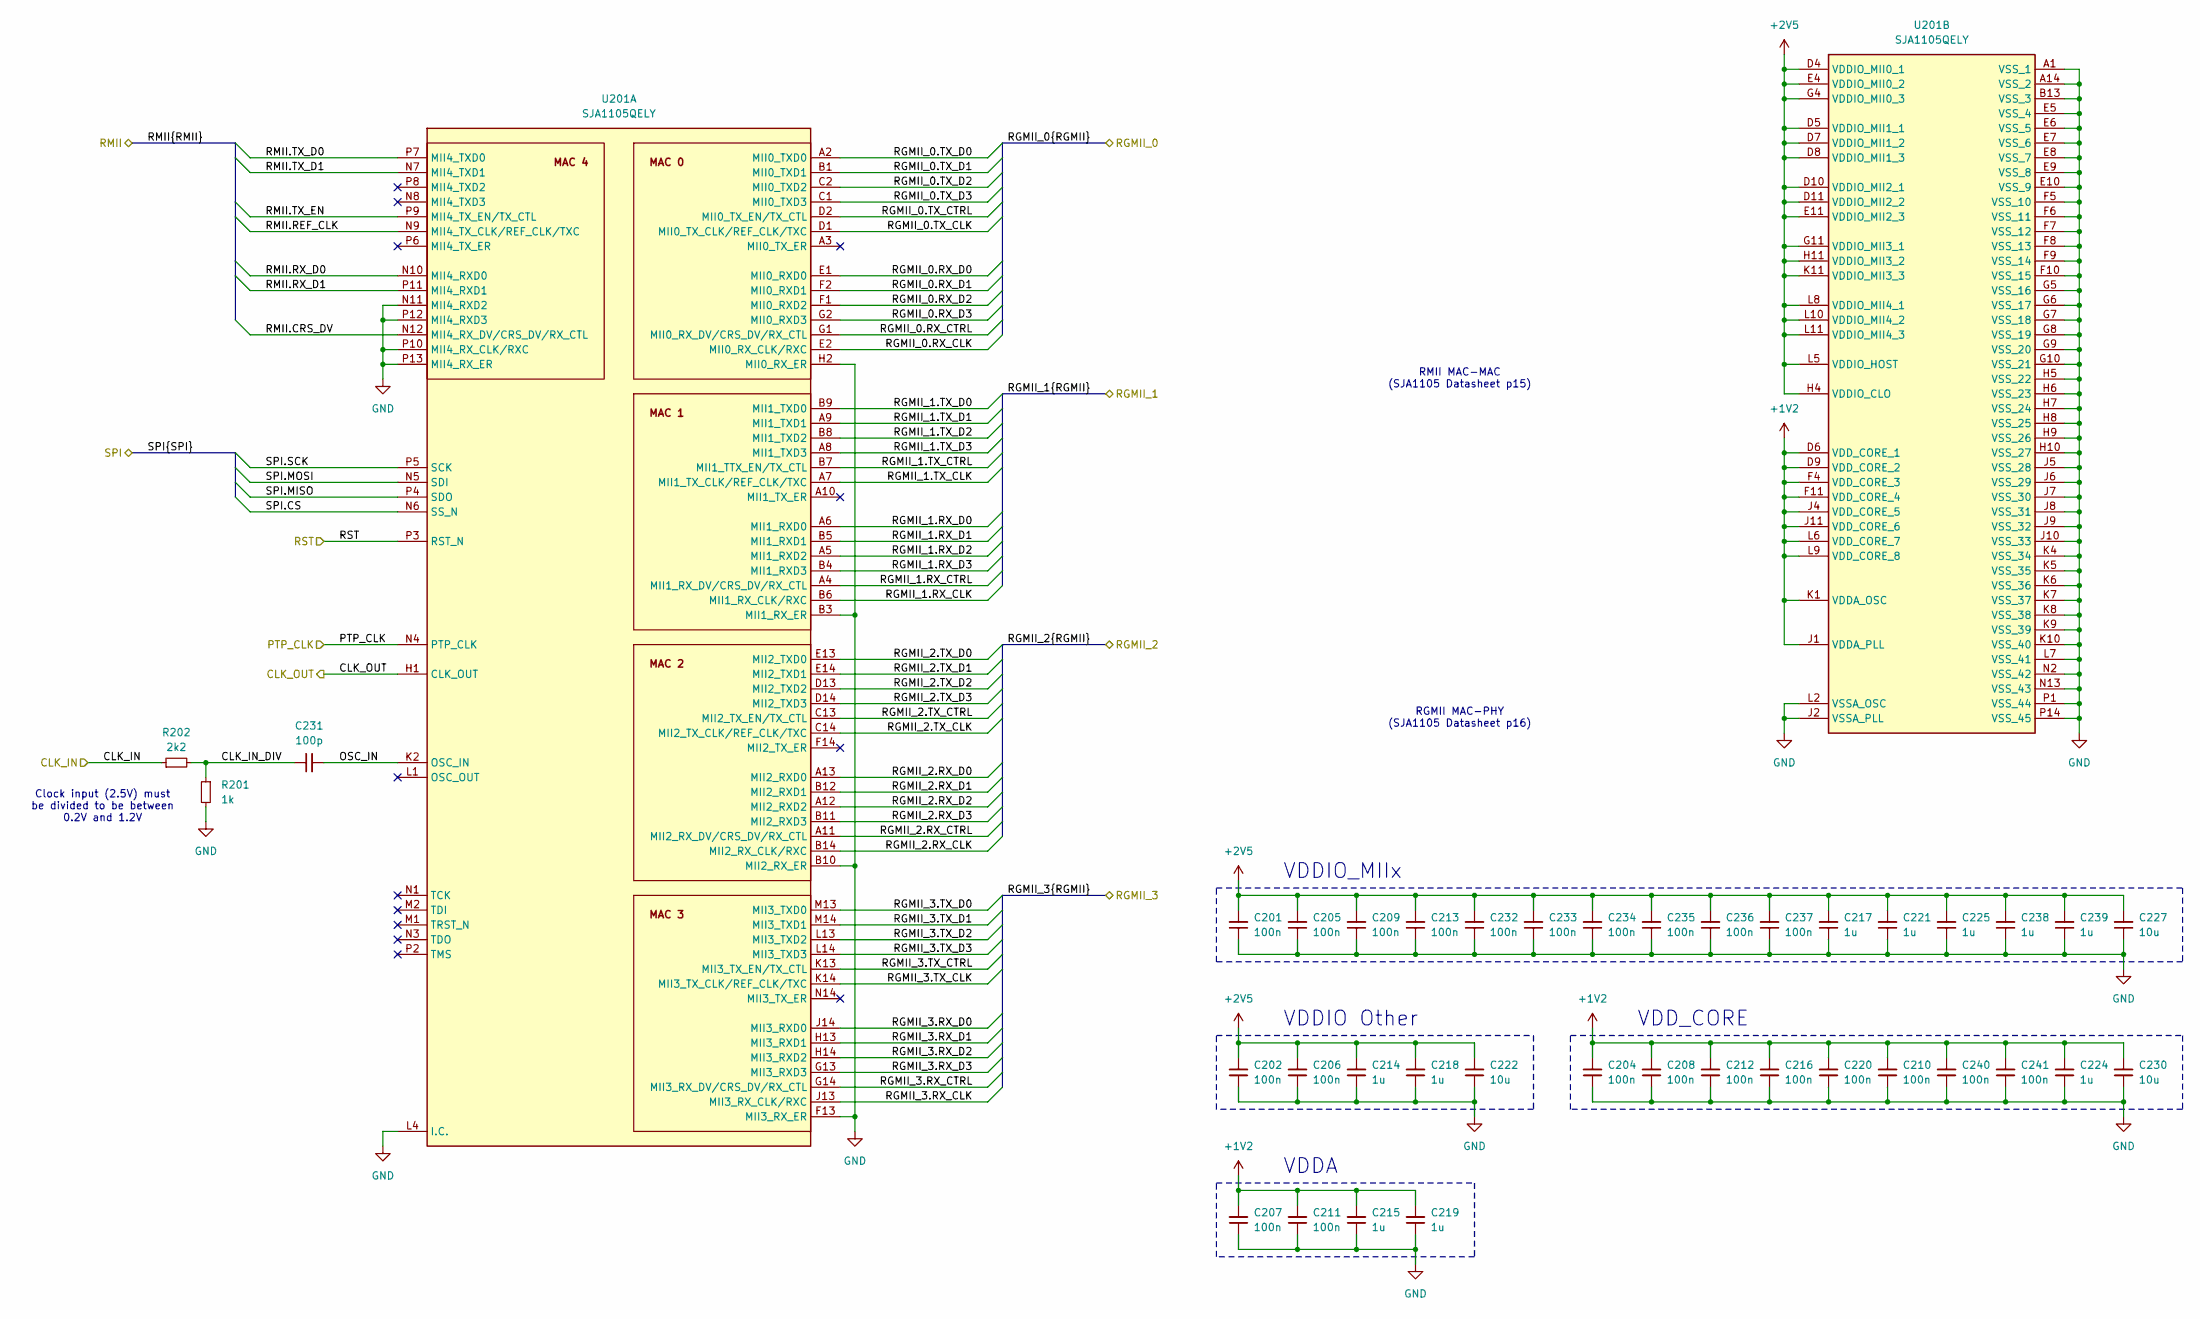
[picture p22: schematic switch.kicad_sch]

Parts:
C201, C202, C204, C205, C206, C207, C208, C209, C210, C211, C212, C213, C216, C220, C232, C233, C234, C235, C236, C237, C240, C241: 100n; C_0402_1005Metric
C214, C215, C217, C218, C219, C221, C224, C225, C238, C239: 1u; C_0402_1005Metric
C222, C227, C230: 10u; C_0402_1005Metric
C231: 100p; C_0402_1005Metric
R201: 1k; R_0402_1005Metric
R202: 2k2; R_0402_1005Metric
U201: SJA1105QELY; BGA159C80P14X14_1200X1200X150; Mouser Part Number 771-SJA1105QELY

Connections:
+1V2: C204.2, C207.2, C208.2, C210.2, C211.2, C212.2, C215.2, C216.2, C219.2, C220.2, C224.2, C230.2, C240.2, C241.2, U201.D6 (VDD_CORE_1), U201.D9 (VDD_CORE_2), U201.F4 (VDD_CORE_3), U201.F11 (VDD_CORE_4), U201.J1 (VDDA_PLL), U201.J4 (VDD_CORE_5), U201.J11 (VDD_CORE_6), U201.K1 (VDDA_OSC), U201.L6 (VDD_CORE_7), U201.L9 (VDD_CORE_8)
+2V5: C201.2, C202.2, C205.2, C206.2, C209.2, C213.2, C214.2, C217.2, C218.2, C221.2, C222.2, C225.2, C227.2, C232.2, C233.2, C234.2, C235.2, C236.2, C237.2, C238.2, C239.2, U201.D4 (VDDIO_MII0_1), U201.D5 (VDDIO_MII1_1), U201.D7 (VDDIO_MII1_2), U201.D8 (VDDIO_MII1_3), U201.D10 (VDDIO_MII2_1), U201.D11 (VDDIO_MII2_2), U201.E4 (VDDIO_MII0_2), U201.E11 (VDDIO_MII2_3), U201.G4 (VDDIO_MII0_3), U201.G11 (VDDIO_MII3_1), U201.H4 (VDDIO_CLO), U201.H11 (VDDIO_MII3_2), U201.K11 (VDDIO_MII3_3), U201.L5 (VDDIO_HOST), U201.L8 (VDDIO_MII4_1), U201.L10 (VDDIO_MII4_2), U201.L11 (VDDIO_MII4_3); also elsewhere on the board
/ETHERNET_RST: U201.P3 (RST_N); also elsewhere on the board
/PHY_1_CLK: U201.H1 (CLK_OUT); also elsewhere on the board
/PTP_CLK: U201.N4 (PTP_CLK); also elsewhere on the board
/RGMII_0.RX_CLK: U201.E2 (MII0_RX_CLK/RXC); also elsewhere on the board
/RGMII_0.RX_CTRL: U201.G1 (MII0_RX_DV/CRS_DV/RX_CTL); also elsewhere on the board
/RGMII_0.RX_D0: U201.E1 (MII0_RXD0); also elsewhere on the board
/RGMII_0.RX_D1: U201.F2 (MII0_RXD1); also elsewhere on the board
/RGMII_0.RX_D2: U201.F1 (MII0_RXD2); also elsewhere on the board
/RGMII_0.RX_D3: U201.G2 (MII0_RXD3); also elsewhere on the board
/RGMII_0.TX_CLK: U201.D1 (MII0_TX_CLK/REF_CLK/TXC); also elsewhere on the board
/RGMII_0.TX_CTRL: U201.D2 (MII0_TX_EN/TX_CTL); also elsewhere on the board
/RGMII_0.TX_D0: U201.A2 (MII0_TXD0); also elsewhere on the board
/RGMII_0.TX_D1: U201.B1 (MII0_TXD1); also elsewhere on the board
/RGMII_0.TX_D2: U201.C2 (MII0_TXD2); also elsewhere on the board
/RGMII_0.TX_D3: U201.C1 (MII0_TXD3); also elsewhere on the board
/RGMII_1.RX_CLK: U201.B6 (MII1_RX_CLK/RXC); also elsewhere on the board
/RGMII_1.RX_CTRL: U201.A4 (MII1_RX_DV/CRS_DV/RX_CTL); also elsewhere on the board
/RGMII_1.RX_D0: U201.A6 (MII1_RXD0); also elsewhere on the board
/RGMII_1.RX_D1: U201.B5 (MII1_RXD1); also elsewhere on the board
/RGMII_1.RX_D2: U201.A5 (MII1_RXD2); also elsewhere on the board
/RGMII_1.RX_D3: U201.B4 (MII1_RXD3); also elsewhere on the board
/RGMII_1.TX_CLK: U201.A7 (MII1_TX_CLK/REF_CLK/TXC); also elsewhere on the board
/RGMII_1.TX_CTRL: U201.B7 (MII1_TTX_EN/TX_CTL); also elsewhere on the board
/RGMII_1.TX_D0: U201.B9 (MII1_TXD0); also elsewhere on the board
/RGMII_1.TX_D1: U201.A9 (MII1_TXD1); also elsewhere on the board
/RGMII_1.TX_D2: U201.B8 (MII1_TXD2); also elsewhere on the board
/RGMII_1.TX_D3: U201.A8 (MII1_TXD3); also elsewhere on the board
/RGMII_2.RX_CLK: U201.B14 (MII2_RX_CLK/RXC); also elsewhere on the board
/RGMII_2.RX_CTRL: U201.A11 (MII2_RX_DV/CRS_DV/RX_CTL); also elsewhere on the board
/RGMII_2.RX_D0: U201.A13 (MII2_RXD0); also elsewhere on the board
/RGMII_2.RX_D1: U201.B12 (MII2_RXD1); also elsewhere on the board
/RGMII_2.RX_D2: U201.A12 (MII2_RXD2); also elsewhere on the board
/RGMII_2.RX_D3: U201.B11 (MII2_RXD3); also elsewhere on the board
/RGMII_2.TX_CLK: U201.C14 (MII2_TX_CLK/REF_CLK/TXC); also elsewhere on the board
/RGMII_2.TX_CTRL: U201.C13 (MII2_TX_EN/TX_CTL); also elsewhere on the board
/RGMII_2.TX_D0: U201.E13 (MII2_TXD0); also elsewhere on the board
/RGMII_2.TX_D1: U201.E14 (MII2_TXD1); also elsewhere on the board
/RGMII_2.TX_D2: U201.D13 (MII2_TXD2); also elsewhere on the board
/RGMII_2.TX_D3: U201.D14 (MII2_TXD3); also elsewhere on the board
/RGMII_3.RX_CLK: U201.J13 (MII3_RX_CLK/RXC); also elsewhere on the board
/RGMII_3.RX_CTRL: U201.G14 (MII3_RX_DV/CRS_DV/RX_CTL); also elsewhere on the board
/RGMII_3.RX_D0: U201.J14 (MII3_RXD0); also elsewhere on the board
/RGMII_3.RX_D1: U201.H13 (MII3_RXD1); also elsewhere on the board
/RGMII_3.RX_D2: U201.H14 (MII3_RXD2); also elsewhere on the board
/RGMII_3.RX_D3: U201.G13 (MII3_RXD3); also elsewhere on the board
/RGMII_3.TX_CLK: U201.K14 (MII3_TX_CLK/REF_CLK/TXC); also elsewhere on the board
/RGMII_3.TX_CTRL: U201.K13 (MII3_TX_EN/TX_CTL); also elsewhere on the board
/RGMII_3.TX_D0: U201.M13 (MII3_TXD0); also elsewhere on the board
/RGMII_3.TX_D1: U201.M14 (MII3_TXD1); also elsewhere on the board
/RGMII_3.TX_D2: U201.L13 (MII3_TXD2); also elsewhere on the board
/RGMII_3.TX_D3: U201.L14 (MII3_TXD3); also elsewhere on the board
/RMII.CRS_DV: U201.N12 (MII4_RX_DV/CRS_DV/RX_CTL); also elsewhere on the board
/RMII.REF_CLK: U201.N9 (MII4_TX_CLK/REF_CLK/TXC); also elsewhere on the board
/RMII.RX_D0: U201.N10 (MII4_RXD0); also elsewhere on the board
/RMII.RX_D1: U201.P11 (MII4_RXD1); also elsewhere on the board
/RMII.TX_D0: U201.P7 (MII4_TXD0); also elsewhere on the board
/RMII.TX_D1: U201.N7 (MII4_TXD1); also elsewhere on the board
/RMII.TX_EN: U201.P9 (MII4_TX_EN/TX_CTL); also elsewhere on the board
/SPI3.CS: U201.N6 (SS_N)
/SPI3.MISO: U201.P4 (SDO)
/SPI3.MOSI: U201.N5 (SDI)
/SPI3.SCK: U201.P5 (SCK)
/SWITCH_CLK: R202.1; also elsewhere on the board
/Switch/CLK_IN_DIV: C231.1, R201.1, R202.2
/Switch/OSC_IN: C231.2, U201.K2 (OSC_IN)
GND: C201.1, C202.1, C204.1, C205.1, C206.1, C207.1, C208.1, C209.1, C210.1, C211.1, C212.1, C213.1, C214.1, C215.1, C216.1, C217.1, C218.1, C219.1, C220.1, C221.1, C222.1, C224.1, C225.1, C227.1, C230.1, C232.1, C233.1, C234.1, C235.1, C236.1, C237.1, C238.1, C239.1, C240.1, C241.1, R201.2, U201.A1 (VSS_1), U201.A14 (VSS_2), U201.B3 (MII1_RX_ER), U201.B10 (MII2_RX_ER), U201.B13 (VSS_3), U201.E5 (VSS_4), U201.E6 (VSS_5), U201.E7 (VSS_6), U201.E8 (VSS_7), U201.E9 (VSS_8), U201.E10 (VSS_9), U201.F5 (VSS_10), U201.F6 (VSS_11), U201.F7 (VSS_12), U201.F8 (VSS_13), U201.F9 (VSS_14), U201.F10 (VSS_15), U201.F13 (MII3_RX_ER), U201.G5 (VSS_16), U201.G6 (VSS_17), U201.G7 (VSS_18), U201.G8 (VSS_19), U201.G9 (VSS_20), U201.G10 (VSS_21), U201.H2 (MII0_RX_ER), U201.H5 (VSS_22), U201.H6 (VSS_23), U201.H7 (VSS_24), U201.H8 (VSS_25), U201.H9 (VSS_26), U201.H10 (VSS_27), U201.J2 (VSSA_PLL), U201.J5 (VSS_28), U201.J6 (VSS_29), U201.J7 (VSS_30), U201.J8 (VSS_31), U201.J9 (VSS_32), U201.J10 (VSS_33), U201.K4 (VSS_34), U201.K5 (VSS_35), U201.K6 (VSS_36), U201.K7 (VSS_37), U201.K8 (VSS_38), U201.K9 (VSS_39), U201.K10 (VSS_40), U201.L2 (VSSA_OSC), U201.L4 (I.C.), U201.L7 (VSS_41), U201.N2 (VSS_42), U201.N11 (MII4_RXD2), U201.N13 (VSS_43), U201.P1 (VSS_44), U201.P10 (MII4_RX_CLK/RXC), U201.P12 (MII4_RXD3), U201.P13 (MII4_RX_ER), U201.P14 (VSS_45); also elsewhere on the board

Notes on the sheet:
VDDIO Other
Clock input (2.5V) must be divided to be between 0.2V and 1.2V
VDDIO_MIIx
RMII MAC-MAC (SJA1105 Datasheet p15)
VDD_CORE
VDDA
RGMII MAC-PHY (SJA1105 Datasheet p16)
