ben5049/GbE-TSN-Switch/PCBs/switch_main_v1/switch_main_v1.kicad_pcb

## KiCad design PCBs/switch_main_v1/switch_main_v1.kicad_pcb (continued)

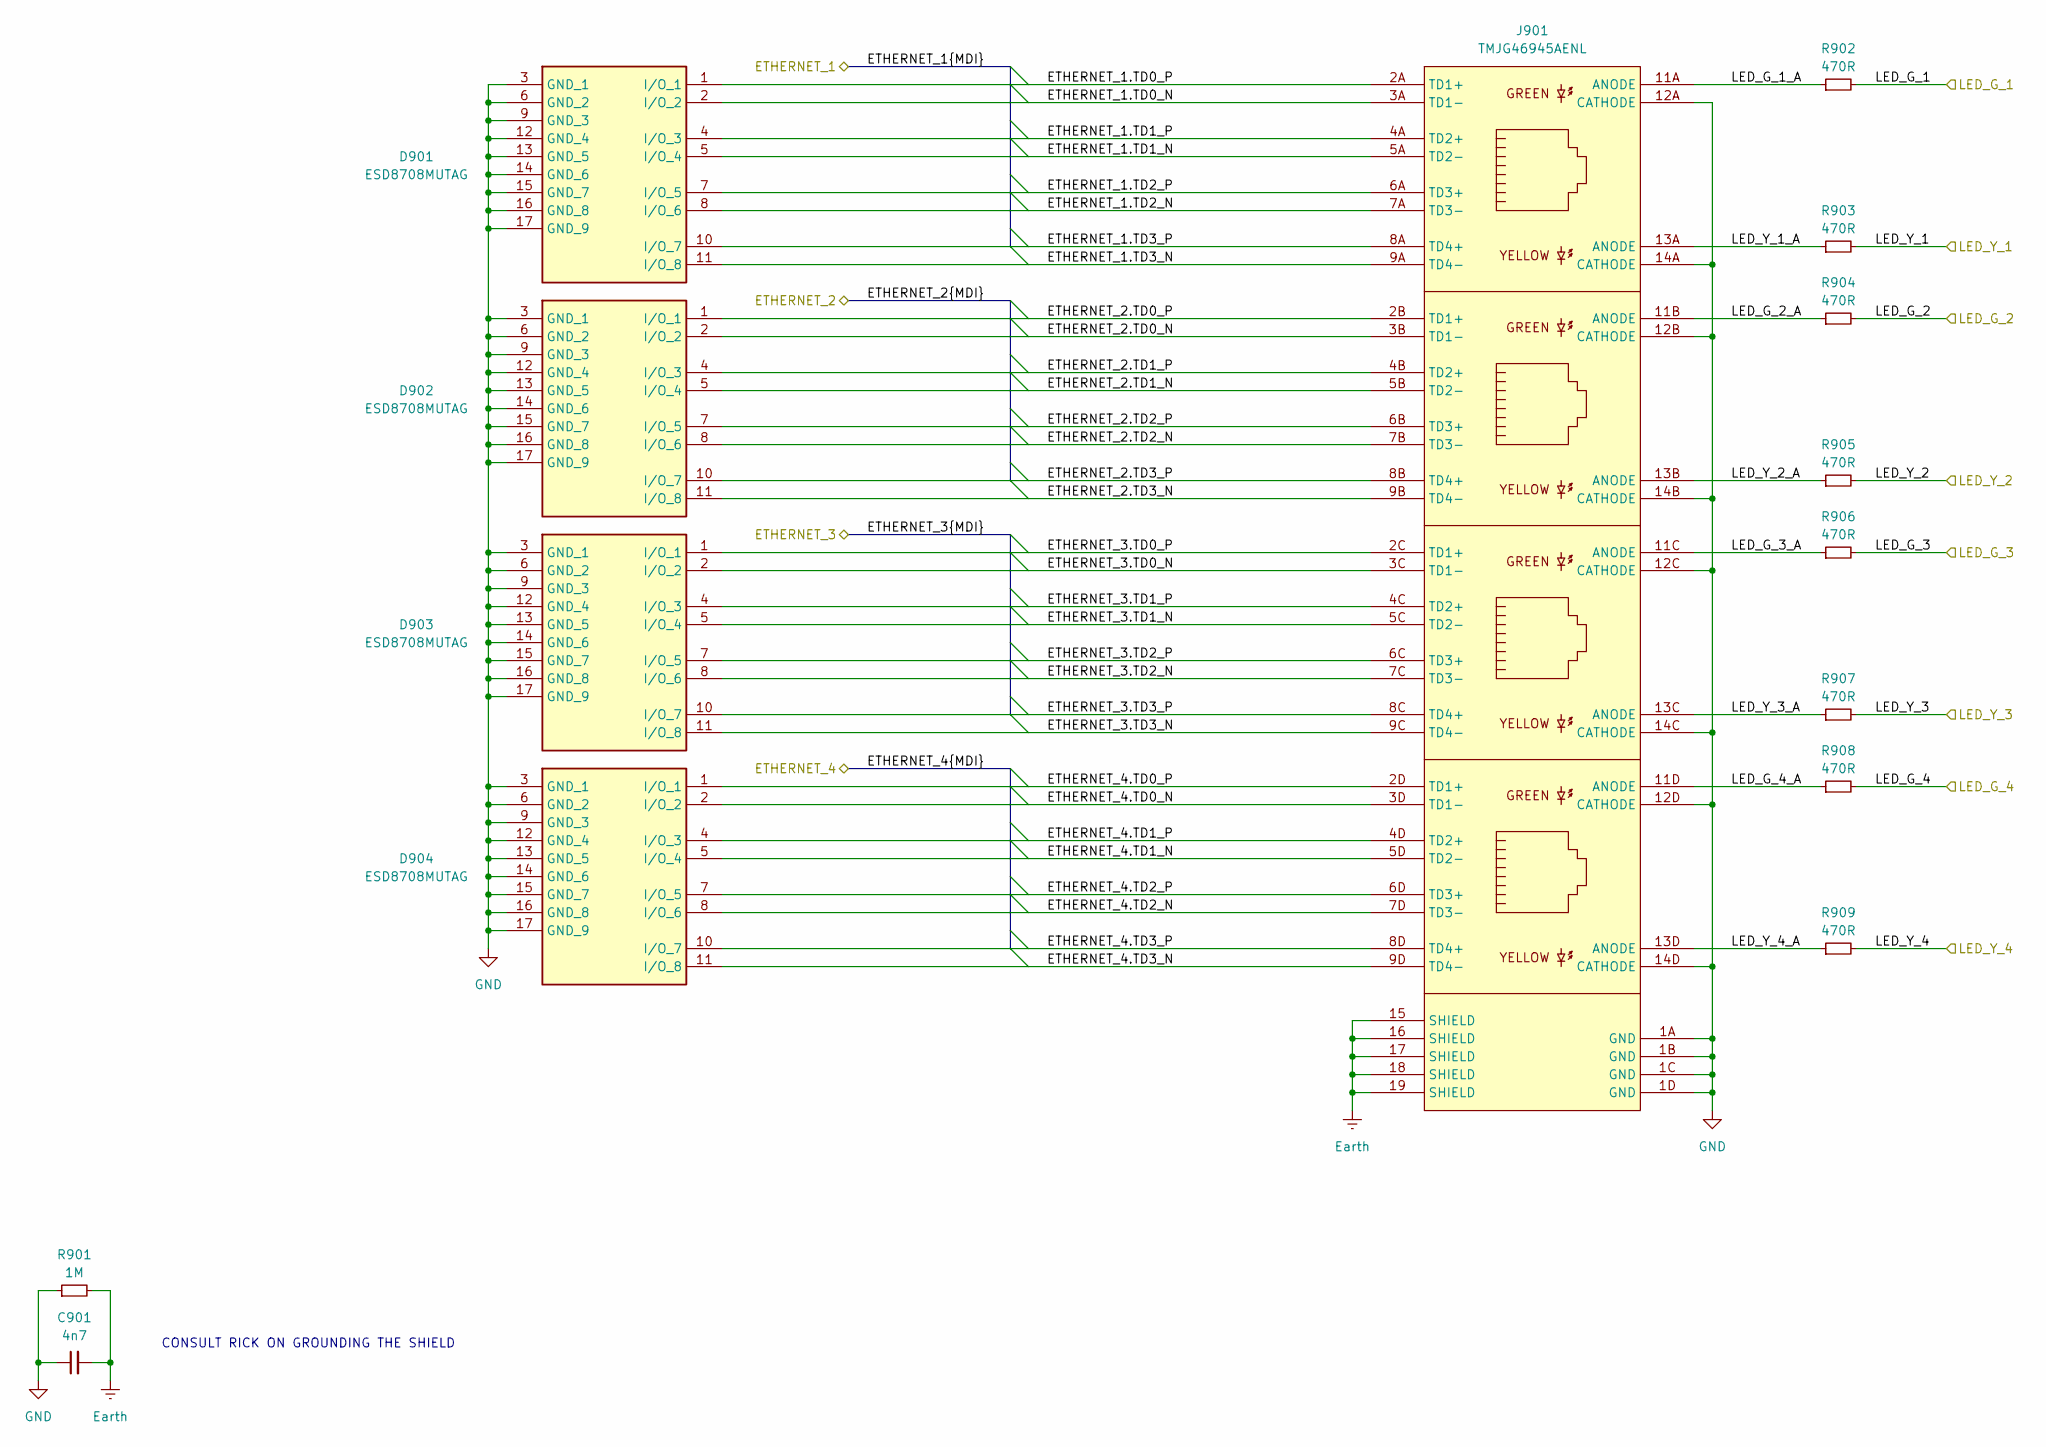
[picture p23: schematic rj45s.kicad_sch, RJ45 Connectors]

Parts:
C901: 4n7; C_0402_1005Metric
D901, D902, D903, D904: ESD8708MUTAG; Mouser Part Number 863-ESD8708MUTAG
J901: TMJG46945AENL
R901: 1M; R_0402_1005Metric
R902, R903, R904, R905, R906, R907, R908, R909: 470R; R_0402_1005Metric

Connections:
/ETHERNET_1.TD0_N: D901.2 (I/O_2), J901.3A (TD1-); also elsewhere on the board
/ETHERNET_1.TD0_P: D901.1 (I/O_1), J901.2A (TD1+); also elsewhere on the board
/ETHERNET_1.TD1_N: D901.5 (I/O_4), J901.5A (TD2-); also elsewhere on the board
/ETHERNET_1.TD1_P: D901.4 (I/O_3), J901.4A (TD2+); also elsewhere on the board
/ETHERNET_1.TD2_N: D901.8 (I/O_6), J901.7A (TD3-); also elsewhere on the board
/ETHERNET_1.TD2_P: D901.7 (I/O_5), J901.6A (TD3+); also elsewhere on the board
/ETHERNET_1.TD3_N: D901.11 (I/O_8), J901.9A (TD4-); also elsewhere on the board
/ETHERNET_1.TD3_P: D901.10 (I/O_7), J901.8A (TD4+); also elsewhere on the board
/ETHERNET_2.TD0_N: D902.2 (I/O_2), J901.3B (TD1-); also elsewhere on the board
/ETHERNET_2.TD0_P: D902.1 (I/O_1), J901.2B (TD1+); also elsewhere on the board
/ETHERNET_2.TD1_N: D902.5 (I/O_4), J901.5B (TD2-); also elsewhere on the board
/ETHERNET_2.TD1_P: D902.4 (I/O_3), J901.4B (TD2+); also elsewhere on the board
/ETHERNET_2.TD2_N: D902.8 (I/O_6), J901.7B (TD3-); also elsewhere on the board
/ETHERNET_2.TD2_P: D902.7 (I/O_5), J901.6B (TD3+); also elsewhere on the board
/ETHERNET_2.TD3_N: D902.11 (I/O_8), J901.9B (TD4-); also elsewhere on the board
/ETHERNET_2.TD3_P: D902.10 (I/O_7), J901.8B (TD4+); also elsewhere on the board
/ETHERNET_3.TD0_N: D903.2 (I/O_2), J901.3C (TD1-); also elsewhere on the board
/ETHERNET_3.TD0_P: D903.1 (I/O_1), J901.2C (TD1+); also elsewhere on the board
/ETHERNET_3.TD1_N: D903.5 (I/O_4), J901.5C (TD2-); also elsewhere on the board
/ETHERNET_3.TD1_P: D903.4 (I/O_3), J901.4C (TD2+); also elsewhere on the board
/ETHERNET_3.TD2_N: D903.8 (I/O_6), J901.7C (TD3-); also elsewhere on the board
/ETHERNET_3.TD2_P: D903.7 (I/O_5), J901.6C (TD3+); also elsewhere on the board
/ETHERNET_3.TD3_N: D903.11 (I/O_8), J901.9C (TD4-); also elsewhere on the board
/ETHERNET_3.TD3_P: D903.10 (I/O_7), J901.8C (TD4+); also elsewhere on the board
/ETHERNET_4.TD0_N: D904.2 (I/O_2), J901.3D (TD1-); also elsewhere on the board
/ETHERNET_4.TD0_P: D904.1 (I/O_1), J901.2D (TD1+); also elsewhere on the board
/ETHERNET_4.TD1_N: D904.5 (I/O_4), J901.5D (TD2-); also elsewhere on the board
/ETHERNET_4.TD1_P: D904.4 (I/O_3), J901.4D (TD2+); also elsewhere on the board
/ETHERNET_4.TD2_N: D904.8 (I/O_6), J901.7D (TD3-); also elsewhere on the board
/ETHERNET_4.TD2_P: D904.7 (I/O_5), J901.6D (TD3+); also elsewhere on the board
/ETHERNET_4.TD3_N: D904.11 (I/O_8), J901.9D (TD4-); also elsewhere on the board
/ETHERNET_4.TD3_P: D904.10 (I/O_7), J901.8D (TD4+); also elsewhere on the board
/LED_G_1: R902.2; also elsewhere on the board
/LED_G_2: R904.2; also elsewhere on the board
/LED_G_3: R906.2; also elsewhere on the board
/LED_G_4: R908.2; also elsewhere on the board
/LED_Y_1: R903.2; also elsewhere on the board
/LED_Y_2: R905.2; also elsewhere on the board
/LED_Y_3: R907.2; also elsewhere on the board
/LED_Y_4: R909.2; also elsewhere on the board
/RJ45s/LED_G_1_A: J901.11A (ANODE), R902.1
/RJ45s/LED_G_2_A: J901.11B (ANODE), R904.1
/RJ45s/LED_G_3_A: J901.11C (ANODE), R906.1
/RJ45s/LED_G_4_A: J901.11D (ANODE), R908.1
/RJ45s/LED_Y_1_A: J901.13A (ANODE), R903.1
/RJ45s/LED_Y_2_A: J901.13B (ANODE), R905.1
/RJ45s/LED_Y_3_A: J901.13C (ANODE), R907.1
/RJ45s/LED_Y_4_A: J901.13D (ANODE), R909.1
Earth: C901.2, J901.15 (SHIELD), J901.16 (SHIELD), J901.17 (SHIELD), J901.18 (SHIELD), J901.19 (SHIELD), R901.2; also elsewhere on the board
GND: C901.1, D901.3 (GND_1), D901.6 (GND_2), D901.9 (GND_3), D901.12 (GND_4), D901.13 (GND_5), D901.14 (GND_6), D901.15 (GND_7), D901.16 (GND_8), D901.17 (GND_9), D902.3 (GND_1), D902.6 (GND_2), D902.9 (GND_3), D902.12 (GND_4), D902.13 (GND_5), D902.14 (GND_6), D902.15 (GND_7), D902.16 (GND_8), D902.17 (GND_9), D903.3 (GND_1), D903.6 (GND_2), D903.9 (GND_3), D903.12 (GND_4), D903.13 (GND_5), D903.14 (GND_6), D903.15 (GND_7), D903.16 (GND_8), D903.17 (GND_9), D904.3 (GND_1), D904.6 (GND_2), D904.9 (GND_3), D904.12 (GND_4), D904.13 (GND_5), D904.14 (GND_6), D904.15 (GND_7), D904.16 (GND_8), D904.17 (GND_9), J901.1A (GND), J901.1B (GND), J901.1C (GND), J901.1D (GND), J901.12A (CATHODE), J901.12B (CATHODE), J901.12C (CATHODE), J901.12D (CATHODE), J901.14A (CATHODE), J901.14B (CATHODE), J901.14C (CATHODE), J901.14D (CATHODE), R901.1; also elsewhere on the board

Notes on the sheet:
CONSULT RICK ON GROUNDING THE SHIELD

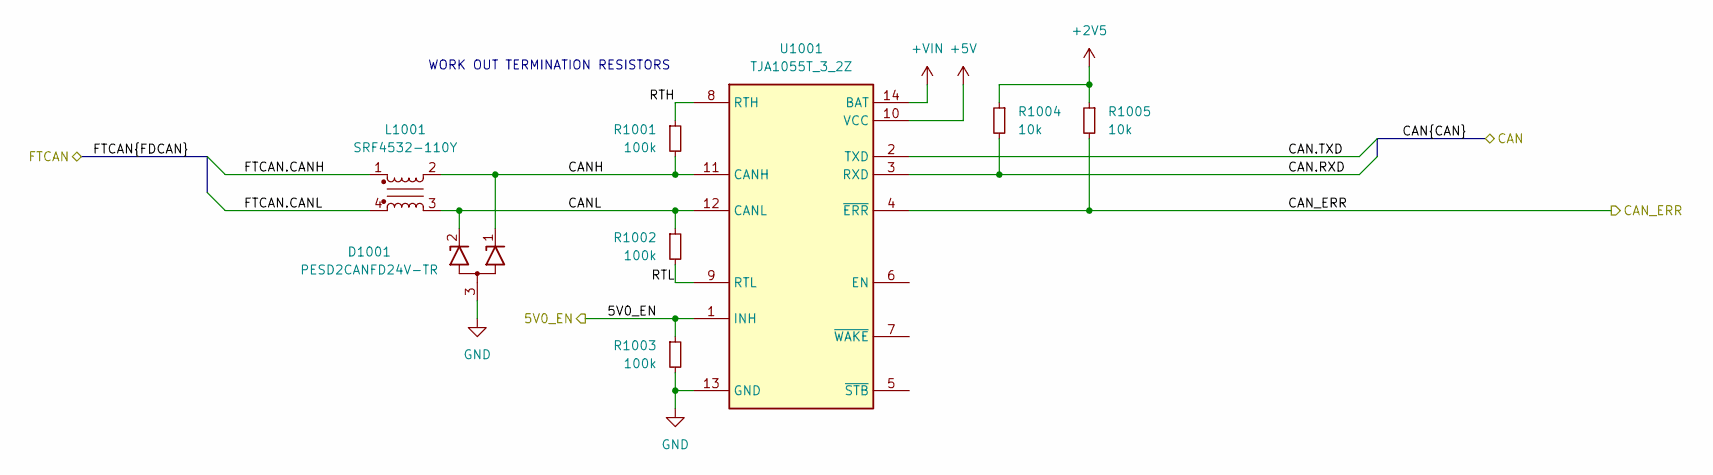
[picture p24: schematic can.kicad_sch]

Parts:
D1001: PESD2CANFD24V-TR; SOT95P230X110-3N; Mouser Part Number 771-PESD2CANFD24V-TR
L1001: SRF4532-110Y; SRF4532101Y; Mouser Part Number 652-SRF4532-110Y
R1001, R1002, R1003: 100k; R_0402_1005Metric
R1004, R1005: 10k; R_0402_1005Metric
U1001: TJA1055T_3_2Z; SOIC127P600X175-14N; Mouser Part Number 771-TJA1055T/3/2Z

Connections:
+2V5: R1004.1, R1005.1; also elsewhere on the board
+5V: U1001.10 (VCC)
+VIN: U1001.14 (BAT); also elsewhere on the board
/5V0_EN: R1003.1, U1001.1 (INH); also elsewhere on the board
/CAN.RXD: R1004.2, U1001.3 (RXD); also elsewhere on the board
/CAN.TXD: U1001.2 (TXD); also elsewhere on the board
/CAN/CANH: D1001.1 (K1), L1001.2, R1001.2, U1001.11 (CANH)
/CAN/CANL: D1001.2 (K2), L1001.3, R1002.1, U1001.12 (CANL)
/CAN/CAN_ERR: R1005.2, U1001.4 (~ERR)
/CAN/FTCAN.CANH: L1001.1
/CAN/FTCAN.CANL: L1001.4
/CAN/RTH: R1001.1, U1001.8 (RTH)
/CAN/RTL: R1002.2, U1001.9 (RTL)
GND: D1001.3 (CC), R1003.2, U1001.13 (GND); also elsewhere on the board

Notes on the sheet:
WORK OUT TERMINATION RESISTORS

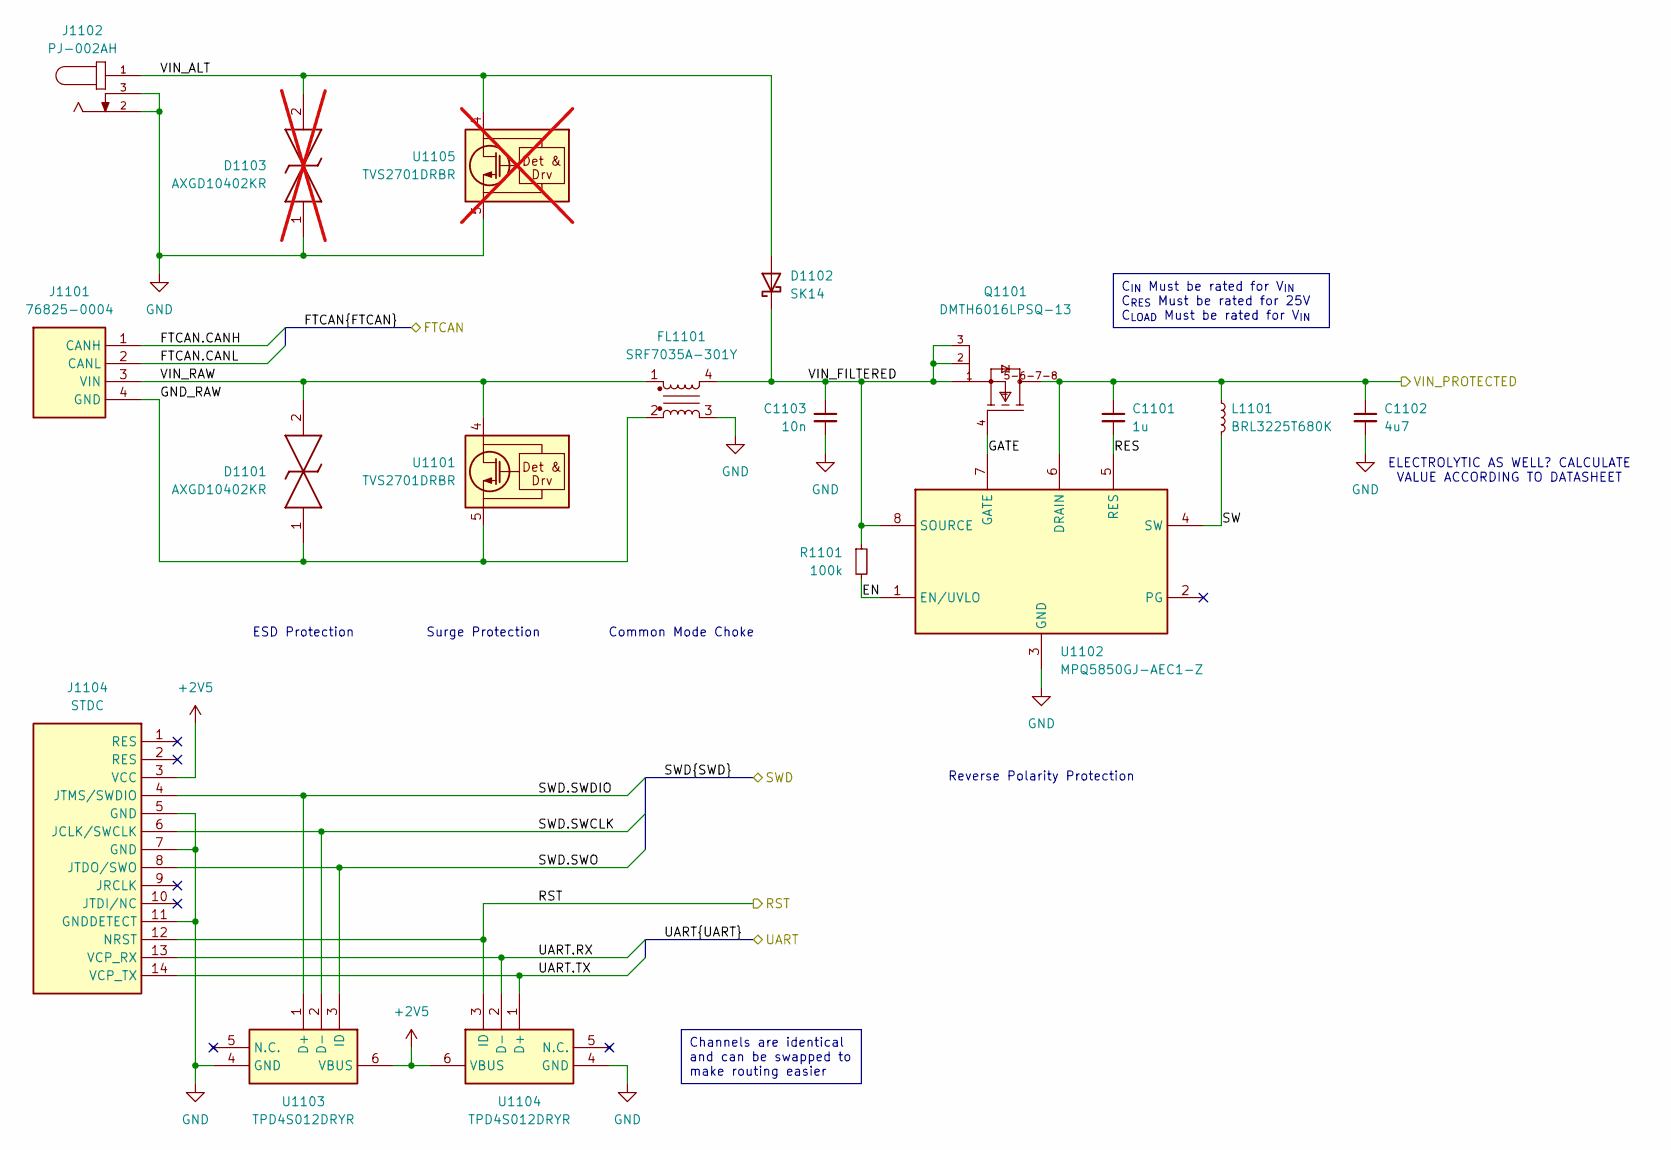
[picture p25: schematic connectors.kicad_sch]

Parts:
C1101: 1u; C_0402_1005Metric
C1102: 4u7; C_0402_1005Metric
C1103: 10n; C_0402_1005Metric
D1101: AXGD10402KR; DIONM105X51N; Mouser Part Number 576-AXGD10402KR
D1102: SK14; D_SMA
D1103: AXGD10402KR; DIONM105X51N; Mouser Part Number 576-AXGD10402KR; not fitted
FL1101: SRF7035A-301Y; SRF7035A301Y; Mouser Part Number 652-SRF7035A-301Y
J1101: 76825-0004; 768250004; Mouser Part Number 538-76825-0004
J1102: PJ-002AH; CUI_PJ-002AH
J1104: STDC; STDC14
L1101: BRL3225T680K; L_1210_3225Metric
Q1101: DMTH6016LPSQ-13; Diodes_Incorporated-PowerDI5060-8-03_2017-0-MFG; mouser part number 621-DMTH6016LPSQ-13; digikey description MOSFET N-CHA 60V 10.6A POWERDI
R1101: 100k; R_0402_1005Metric
U1101: TVS2701DRBR; SON65P300X300X100-9N-D; Mouser Part Number 595-TVS2701DRBR
U1102: MPQ5850GJ-AEC1-Z; SOT65P280X100-8N; Manufacturer_Part_Number MPQ5850GJ-AEC1-Z
U1103, U1104: TPD4S012DRYR; Mouser Part Number 595-TPD4S012DRYR
U1105: TVS2701DRBR; SON65P300X300X100-9N-D; Mouser Part Number 595-TVS2701DRBR; not fitted

Connections:
+2V5: J1104.3 (VCC), U1103.6 (VBUS), U1104.6 (VBUS); also elsewhere on the board
/Connectors/EN: R1101.2, U1102.1 (EN/UVLO)
/Connectors/GATE: Q1101.4 (G), U1102.7 (GATE)
/Connectors/GND_RAW: D1101.1, FL1101.2, J1101.4 (GND), U1101.5 (GND), U1101.6 (GND), U1101.7 (GND), U1101.8 (GND)
/Connectors/RES: C1101.2, U1102.5 (RES)
/Connectors/SW: L1101.2, U1102.4 (SW)
/Connectors/VIN_ALT: D1102.2 (A), D1103.2, J1102.1, U1105.1 (IN), U1105.2 (IN), U1105.3 (IN), U1105.4 (IN)
/Connectors/VIN_FILTERED: C1103.1, D1102.1 (K), FL1101.4, Q1101.1 (S), Q1101.2 (S), Q1101.3 (S), R1101.1, U1102.8 (SOURCE)
/Connectors/VIN_PROTECTED: C1101.1, C1102.1, L1101.1, Q1101.5-6-7-8 (D), U1102.6 (DRAIN); also elsewhere on the board
/Connectors/VIN_RAW: D1101.2, FL1101.1, J1101.3 (VIN), U1101.1 (IN), U1101.2 (IN), U1101.3 (IN), U1101.4 (IN)
/FTCAN.CANH: J1101.1 (CANH)
/FTCAN.CANL: J1101.2 (CANL)
/MCU_RST: J1104.12 (NRST), U1104.3 (ID); also elsewhere on the board
/SWD.SWCLK: J1104.6 (JCLK/SWCLK), U1103.2 (D-); also elsewhere on the board
/SWD.SWDIO: J1104.4 (JTMS/SWDIO), U1103.1 (D+); also elsewhere on the board
/SWD.SWO: J1104.8 (JTDO/SWO), U1103.3 (ID); also elsewhere on the board
/UART.RX: J1104.13 (VCP_RX), U1104.2 (D-)
/UART.TX: J1104.14 (VCP_TX), U1104.1 (D+)
GND: C1102.2, C1103.2, D1103.1, FL1101.3, J1102.2, J1102.3, J1104.5 (GND), J1104.7 (GND), J1104.11 (GNDDETECT), U1102.3 (GND), U1103.4 (GND), U1104.4 (GND), U1105.5 (GND), U1105.6 (GND), U1105.7 (GND), U1105.8 (GND); also elsewhere on the board

Notes on the sheet:
Channels are identical and can be swapped to make routing easier
C_{IN} Must be rated for V_{IN} C_{RES} Must be rated for 25V C_{LOAD} Must be rated for V_{IN}
Surge Protection
Common Mode Choke
ESD Protection
ELECTROLYTIC AS WELL? CALCULATE VALUE ACCORDING TO DATASHEET
Reverse Polarity Protection

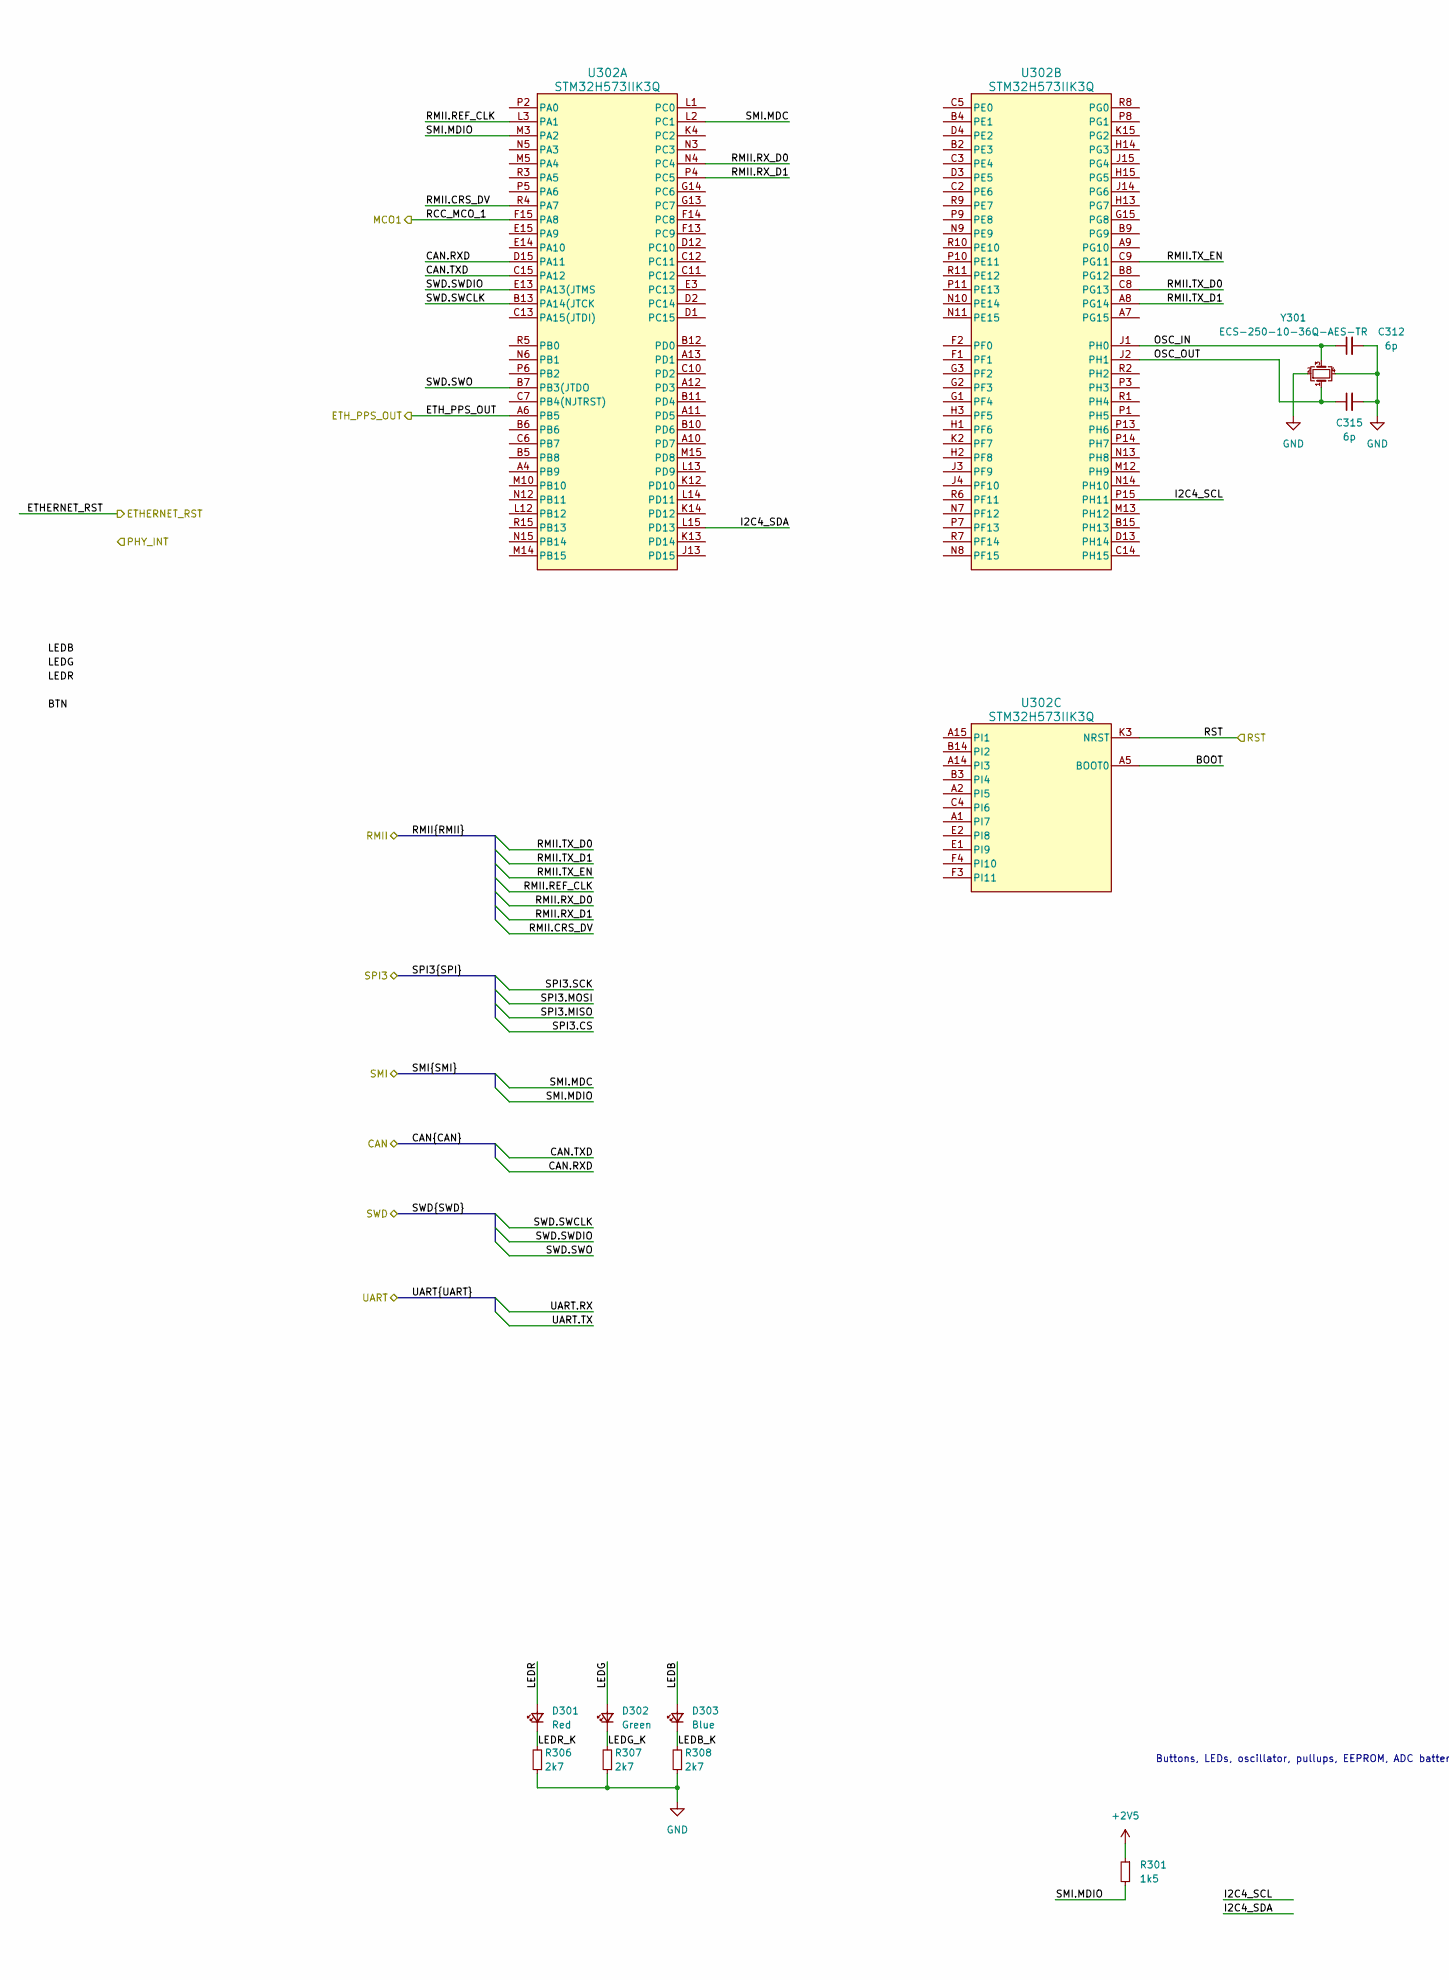
[picture p26: schematic mcu.kicad_sch, part in row 1, column 1]

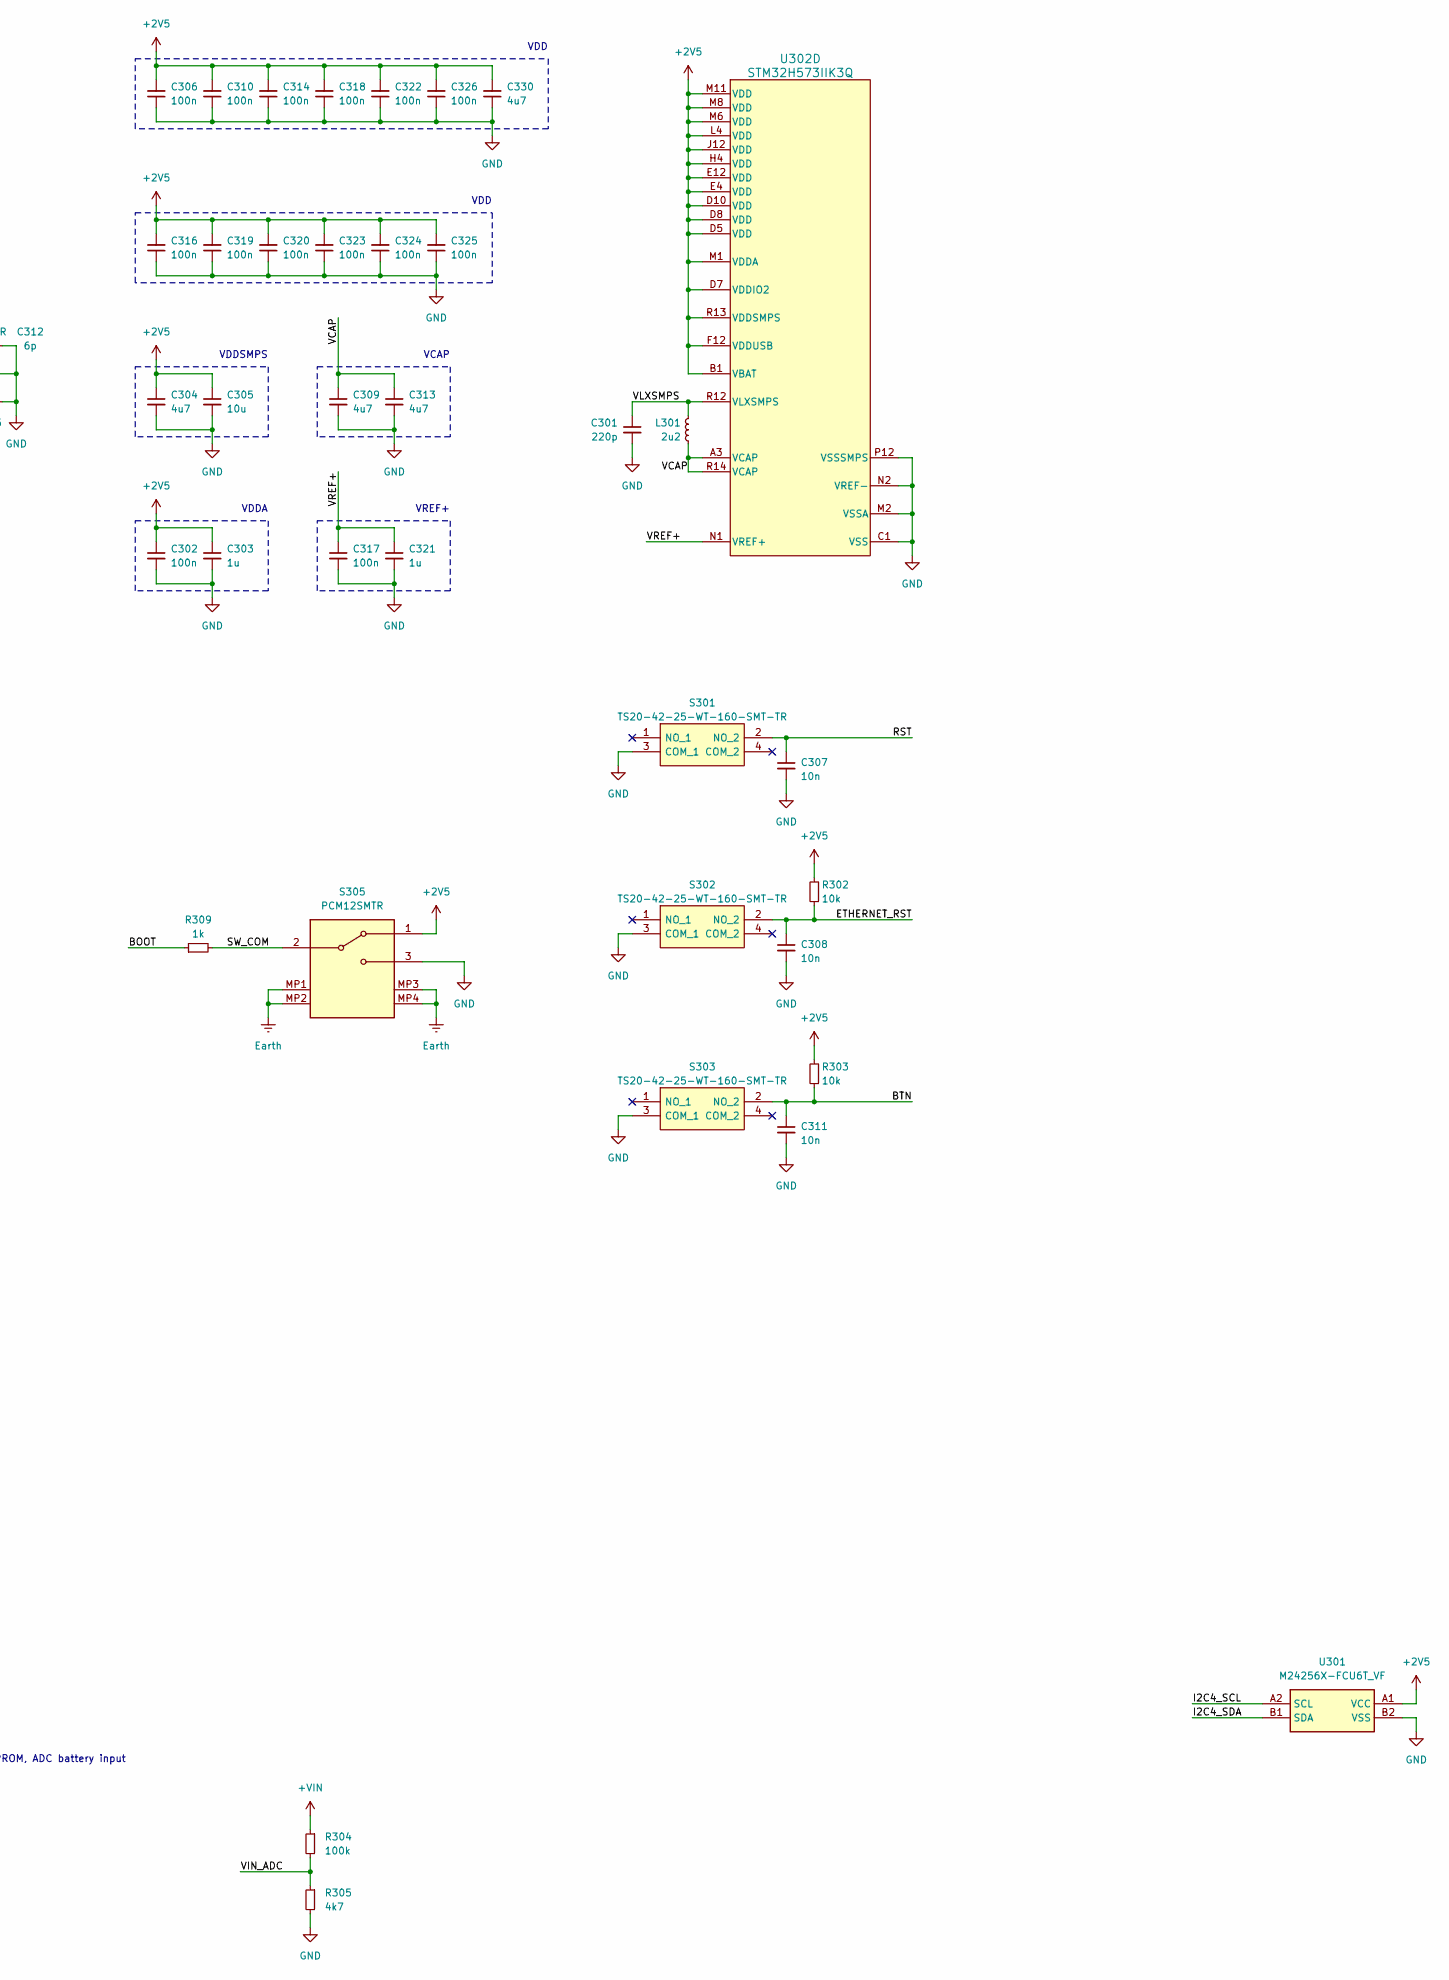
[picture p27: schematic mcu.kicad_sch, part in row 1, column 2]

Parts:
C301: 220p; C_0402_1005Metric
C302, C306, C310, C314, C316, C317, C318, C319, C320, C322, C323, C324, C325, C326: 100n; C_0402_1005Metric
C303, C321: 1u; C_0402_1005Metric
C304, C309, C313, C330: 4u7; C_0402_1005Metric
C305: 10u; C_0402_1005Metric
C307, C308, C311: 10n; C_0402_1005Metric
C312, C315: 6p; C_0402_1005Metric
D301: Red; LED_0402_1005Metric
D302: Green; LED_0402_1005Metric
D303: Blue; LED_0402_1005Metric
L301: 2u2; L_Murata_DFE201610P
R301: 1k5; R_0402_1005Metric
R302, R303: 10k; R_0402_1005Metric
R304: 100k; R_0402_1005Metric
R305: 4k7; R_0402_1005Metric
R306, R307, R308: 2k7; R_0402_1005Metric
R309: 1k; R_0402_1005Metric
S301, S302, S303: TS20-42-25-WT-160-SMT-TR; TS204225WT160SMTTRMSL; Mouser Part Number 179-TS204225WT160SMT
S305: PCM12SMTR; Mouser Part Number 611-PCM12SMTR
U301: M24256X-FCU6T_VF; BGA4C50P2X2_70X98X33; Mouser Part Number 511-M24256X-FCU6T/VF
U302: STM32H573IIK3Q
Y301: ECS-250-10-36Q-AES-TR; Crystal_SMD_2520-4Pin_2.5x2.0mm

Connections:
+2V5: C302.1, C303.1, C304.1, C305.1, C306.2, C310.2, C314.2, C316.2, C318.2, C319.2, C320.2, C322.2, C323.2, C324.2, C325.2, C326.2, C330.2, R301.1, R302.2, R303.2, S305.1 (A), U301.A1 (VCC), U302.B1 (VBAT), U302.D5 (VDD), U302.D7 (VDDIO2), U302.D8 (VDD), U302.D10 (VDD), U302.E4 (VDD), U302.E12 (VDD), U302.F12 (VDDUSB), U302.H4 (VDD), U302.J12 (VDD), U302.L4 (VDD), U302.M1 (VDDA), U302.M6 (VDD), U302.M8 (VDD), U302.M11 (VDD), U302.R13 (VDDSMPS); also elsewhere on the board
+VIN: R304.1; also elsewhere on the board
/CAN.RXD: U302.D15 (PA11); also elsewhere on the board
/CAN.TXD: U302.C15 (PA12); also elsewhere on the board
/ETHERNET_RST: C308.1, R302.1, S302.2 (NO_2); also elsewhere on the board
/MCU/BOOT: R309.1, U302.A5 (BOOT0)
/MCU/BTN: C311.1, R303.1, S303.2 (NO_2)
/MCU/I2C4_SCL: U301.A2 (SCL), U302.P15 (PH11)
/MCU/I2C4_SDA: U301.B1 (SDA), U302.L15 (PD13)
/MCU/LEDB: D303.2 (A)
/MCU/LEDB_K: D303.1 (K), R308.2
/MCU/LEDG: D302.2 (A)
/MCU/LEDG_K: D302.1 (K), R307.2
/MCU/LEDR: D301.2 (A)
/MCU/LEDR_K: D301.1 (K), R306.2
/MCU/OSC_IN: C312.1, U302.J1 (PH0), Y301.3
/MCU/OSC_OUT: C315.1, U302.J2 (PH1), Y301.1
/MCU/SW_COM: R309.2, S305.2 (B)
/MCU/VCAP: C309.1, C313.1, L301.2, U302.A3 (VCAP), U302.R14 (VCAP)
/MCU/VIN_ADC: R304.2, R305.1
/MCU/VLXSMPS: C301.1, L301.1, U302.R12 (VLXSMPS)
/MCU/VREF+: C317.1, C321.1, U302.N1 (VREF+)
/MCU_RST: C307.1, S301.2 (NO_2), U302.K3 (NRST); also elsewhere on the board
/PTP_CLK: U302.A6 (PB5); also elsewhere on the board
/RMII.CRS_DV: U302.R4 (PA7); also elsewhere on the board
/RMII.REF_CLK: U302.L3 (PA1); also elsewhere on the board
/RMII.RX_D0: U302.N4 (PC4); also elsewhere on the board
/RMII.RX_D1: U302.P4 (PC5); also elsewhere on the board
/RMII.TX_D0: U302.C8 (PG13); also elsewhere on the board
/RMII.TX_D1: U302.A8 (PG14); also elsewhere on the board
/RMII.TX_EN: U302.C9 (PG11); also elsewhere on the board
/SMI.MDC: U302.L2 (PC1); also elsewhere on the board
/SMI.MDIO: R301.2, U302.M3 (PA2); also elsewhere on the board
/SWD.SWCLK: U302.B13 (PA14(JTCK); also elsewhere on the board
/SWD.SWDIO: U302.E13 (PA13(JTMS); also elsewhere on the board
/SWD.SWO: U302.B7 (PB3(JTDO); also elsewhere on the board
/SWITCH_CLK: U302.F15 (PA8); also elsewhere on the board
Earth: S305.MP1, S305.MP2, S305.MP3, S305.MP4; also elsewhere on the board
GND: C301.2, C302.2, C303.2, C304.2, C305.2, C306.1, C307.2, C308.2, C309.2, C310.1, C311.2, C312.2, C313.2, C314.1, C315.2, C316.1, C317.2, C318.1, C319.1, C320.1, C321.2, C322.1, C323.1, C324.1, C325.1, C326.1, C330.1, R305.2, R306.1, R307.1, R308.1, S301.3 (COM_1), S302.3 (COM_1), S303.3 (COM_1), S305.3 (C), U301.B2 (VSS), U302.C1 (VSS), U302.D6 (VSS), U302.D9 (VSS), U302.D11 (VSS), U302.D14 (VSS), U302.F6 (VSS), U302.F7 (VSS), U302.F8 (VSS), U302.F9 (VSS), U302.F10 (VSS), U302.G4 (VSS), U302.G6 (VSS), U302.G7 (VSS), U302.G8 (VSS), U302.G9 (VSS), U302.G10 (VSS), U302.G12 (VSS), U302.H6 (VSS), U302.H7 (VSS), U302.H8 (VSS), U302.H9 (VSS), U302.H10 (VSS), U302.H12 (VSS), U302.J6 (VSS), U302.J7 (VSS), U302.J8 (VSS), U302.J9 (VSS), U302.J10 (VSS), U302.K1 (VSS), U302.K6 (VSS), U302.K7 (VSS), U302.K8 (VSS), U302.K9 (VSS), U302.K10 (VSS), U302.M2 (VSSA), U302.M4 (VSS), U302.M7 (VSS), U302.M9 (VSS), U302.N2 (VREF-), U302.P12 (VSSSMPS), Y301.2, Y301.4; also elsewhere on the board

Notes on the sheet:
VDD
VDDA
Buttons, LEDs, oscillator, pullups, EEPROM, ADC battery input
VDDSMPS
VREF+
VCAP

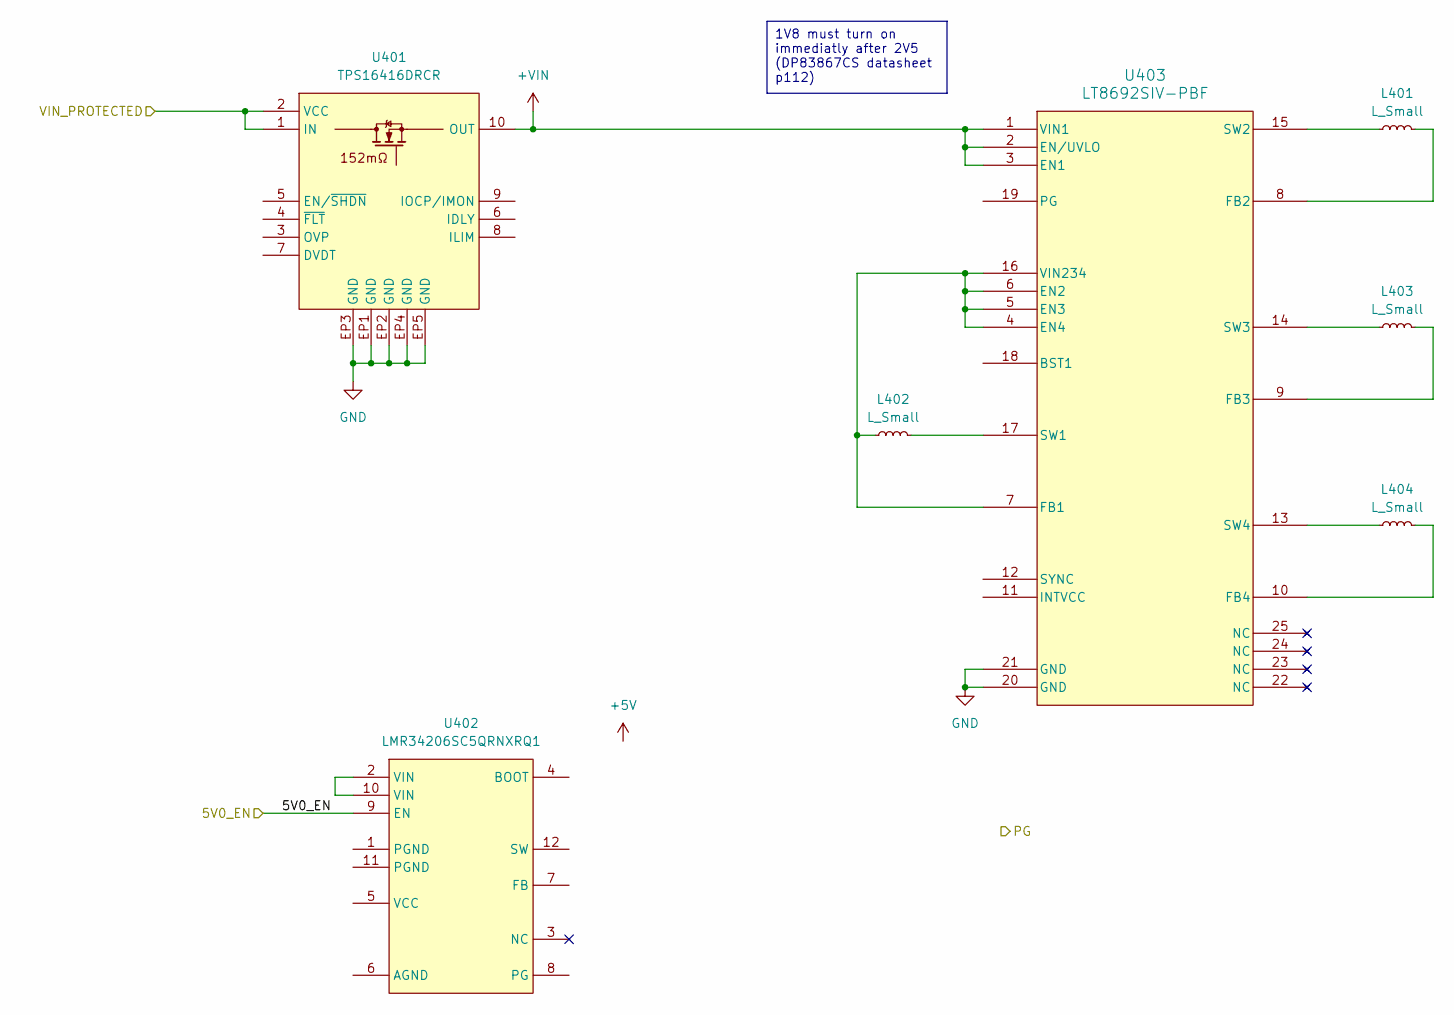
[picture p28: schematic power.kicad_sch]

Parts:
L401, L402, L403, L404: L_Small
U401: TPS16416DRCR; TPS74901DRCR; Mouser Part Number 595-TPS16416DRCR
U402: LMR34206SC5QRNXRQ1; CONV_LMR33620BRNXT
U403: LT8692SIV-PBF; LT8692SIV_PBF

Connections:
+VIN: U401.10 (OUT), U403.1 (VIN1), U403.2 (EN/UVLO), U403.3 (EN1); also elsewhere on the board
/5V0_EN: U402.9 (EN); also elsewhere on the board
/Connectors/VIN_PROTECTED: U401.1 (IN), U401.2 (VCC); also elsewhere on the board
GND: U401.EP1 (GND), U401.EP2 (GND), U401.EP3 (GND), U401.EP4 (GND), U401.EP5 (GND), U403.20 (GND), U403.21 (GND); also elsewhere on the board
unnamed: U402.2 (VIN), U402.10 (VIN)
unnamed: L402.1, U403.4 (EN4), U403.5 (EN3), U403.6 (EN2), U403.7 (FB1), U403.16 (VIN234)
unnamed: L401.2, U403.8 (FB2)
unnamed: L403.2, U403.9 (FB3)
unnamed: L404.2, U403.10 (FB4)
unnamed: L402.2, U403.17 (SW1)
unnamed: L401.1, U403.15 (SW2)
unnamed: L403.1, U403.14 (SW3)
unnamed: L404.1, U403.13 (SW4)

Notes on the sheet:
1V8 must turn on immediatly after 2V5 (DP83867CS datasheet p112)

Board: 2 copper layers, 290 parts (0 on the bottom side), 173 nets, no tracks yet.
