ben5049/GbE-TSN-Switch/Firmware/pinout/pinout.ioc

Mcu.UserName=STM32H573IIKxQ
PA1.Signal=ETH_REF_CLK
PA11.Signal=FDCAN1_RX
PA12.Signal=FDCAN1_TX
PA13(JTMS/SWDIO).Signal=DEBUG_JTMS-SWDIO
PA14(JTCK/SWCLK).Signal=DEBUG_JTCK-SWCLK
PA2.Signal=ETH_MDIO
PA7.Signal=ETH_CRS_DV
PA8.Signal=RCC_MCO_1
PB3(JTDO/TRACESWO).Signal=DEBUG_JTDO-SWO
PB5.Signal=ETH_PPS_OUT
PC1.Signal=ETH_MDC
PC4.Signal=ETH_RXD0
PC5.Signal=ETH_RXD1
PD13.Signal=I2C4_SDA
PG11.Signal=ETH_TX_EN
PG13.Signal=ETH_TXD0
PG14.Signal=ETH_TXD1
PH0-OSC_IN(PH0).Signal=RCC_OSC_IN
PH1-OSC_OUT(PH1).Signal=RCC_OSC_OUT
PH11.Signal=I2C4_SCL
