ben5049/GbE-TSN-Switch/(commit log)

2024-04-05 System architecture chosen. Schematic started.
    [76825-0004.stp, AXGD10402KR.stp, DP83867CSRGZR.stp, LMR34206SC5QRNXRQ1.step, LT8692s.step, MPQ5850GJ-AEC1-Z.stp, SJA1105QELY.stp, STM32H573RIV6.stp]
2024-04-05 Connectors schematic almost complete
    [Diodes_Incorporated_-_DMTH6016LPSQ-13.step, M24256X-FCU6T_VF.stp, PJ-002AH.stp, TS20-42-25-WT-160-SMT-TR-MSL.stp, can.kicad_sch, connectors.kicad_sch, mcu.kicad_sch, power.kicad_sch]
2024-04-06 Added schematic annotations
    [can.kicad_sch, connectors.kicad_sch, switch.kicad_sch]
2024-04-06 Schematic progress
    [PESD2CANFD24V-TR.stp, can.kicad_sch, connectors.kicad_sch, mcu.kicad_sch, phy.kicad_sch, rj45s.kicad_sch, switch.kicad_sch, switch_main_v1.kicad_sch]
2024-04-07 Block diagram layout change
    [can.kicad_sch, connectors.kicad_sch, mcu.kicad_sch, phy.kicad_sch, power.kicad_sch, rj45s.kicad_sch, switch.kicad_sch, switch_main_v1.kicad_pcb]
2024-04-07 GbE part of schematic done
    [ESD8708MUTAG.stp, can.kicad_sch, connectors.kicad_sch, mcu.kicad_sch, phy.kicad_sch, power.kicad_sch, rj45s.kicad_sch, switch.kicad_sch]
2024-04-08 Common mode choke needed on power input
    [connectors.kicad_sch]
2024-04-09 Progress on CAN schematic sheet
    [SRF4532-110Y.stp, SRF7035A-301Y.stp, can.kicad_sch, connectors.kicad_sch, mcu.kicad_sch, switch_main_v1.kicad_sch]
2024-04-10 Changed MCU to STM32H573VIT3Q
    [STM32H573RIV6.stp, can.kicad_sch, connectors.kicad_sch, mcu.kicad_sch, phy.kicad_sch, power.kicad_sch, switch_main_v1.kicad_sch]
2024-04-11 Changed MCU to STM32H573IIK3Q
    [FTSH-107-01-L-DV-K.stp, PCM12SMTR.stp, STM32H573IIK3Q.step, STM32H573IIK3Q.stp, TPD4S012DRYR.stp, can.kicad_sch, connectors.kicad_sch, mcu.kicad_sch]
