ben5049/GbE-TSN-Switch/(notices)

Notices in the files:
PCBs/component_library/switch_models/FTSH-107-01-L-DV-K.stp:
author */ ('License CC BY-ND 4.0'),
